Mines-Rocketry-Club/liquid-halfCat/PurchaseItems.xlsx

Sheet: Total
Number | Item | Category | Part Number | Source | Unit Price | QTY | Cost | Context | Notes
F-6 | High-Pressure Braided Chemical Hose with Fittings Brass 1/2"-20 Thread Size Flare UNF Female, 3/8" OD - 42" | Tubing | 4468K812-4468K858 | https://www.mcmaster.com/4468K812-4468K858/ | $31.43 | 1 | $31.43 | Fuel Line 42" Section
F-7 | High-Pressure Braided Chemical Hose with Fittings Brass 1/2"-20 Thread Size Flare UNF Female, 3/8" OD - 14" | Tubing | 4468K812-4468K031 | https://www.mcmaster.com/4468K812-4468K031/ | $19.32 | 1 | $19.32 | Fuel Line 14" Section
F-8 | High-Pressure Braided Chemical Hose with Fittings Brass 9/16"-18 Thread Size Flare UNF Female, 7/16" OD - 12" | Tubing | 4468K813-4468K865 | https://www.mcmaster.com/4468K813-4468K865/ | $26.22 | 1 | $26.22 | Oxidizer Line
F-11 | Nylon Tubing, 1/4" OD, 800PSI, 10ft | Tubing | 9685T3 | https://www.mcmaster.com/9685t3/ | $11.50 | 1 | $11.50 | Fill tube | Select 10 ft length for order
P-1 | 6061 Aluminum Round 4"D X 1/2"L | Stock | 1610T37-1610T134 | https://www.mcmaster.com/1610T37-1610T134/ | $14.21 | 2 | $28.42 | Tank Bulkheads - To be machined into BKHD-FL-O238-4NPT2X250C and BKHD-OX-O238-8NPT4NPT
P-2 | 6061 Aluminum Round 4"D X 3"L | Stock | 1610737-1610T33 | https://www.mcmaster.com/1610T37-1610T33/ | $44.40 | 1 | $44.40 | Tank Piston - To be machined into PSTN-2XO238-250T20
P-3 | 6061 Aluminum Tube 4"D X 1/8"W X 36"L | Stock | 9056K42-9056K423 | https://www.mcmaster.com/9056K42-9056K423 | $82.72 | 1 | $82.72 | Tank Casing - To be machined into TANK-36L-047V2X8X313C
P-4 | 6061 Aluminum Tube 4"OD X 1/2"W X 3"L | Stock | 7392T263 | https://www.mcmaster.com/7392T263/ | $15.71 | 2 | $31.42 | Bolted Tank Rings - To be machined into INRG-200S-8X125C8X250C
F-15 | 3/4" X 6" 6061-T6 Round Bar | Stock | 8974K11-8974K299 | https://www.mcmaster.com/8974K11-8974K299/ | $3.68 | 1 | $3.68 | QD Stock - To be machined into QDC-750X125FLG-281FB8NPT and QDC-750x125FLG-270MB-O007
T-1 | 6061 Aluminum Round 3"D X 6"L | Stock | 8974K82-1610T41 | https://www.mcmaster.com/8974K82-1610T41/ | $47.24 | 1 | $47.24 | Nozzle and injector stock - To be machined into INJC-2X8NPT-38NPT-250T20-2XO230-BASIC and NZZL-45C20D-200E
T-2 | 6061 Aluminum Tube 3"D X 1/2"W X 6"L | Stock | 9056K23-9056K235 | https://www.mcmaster.com/9056K23-9056K235/ | $39.29 | 1 | $39.29 | Chamber Tube - To be machined into CMBR-200DI-250B-525L
T-3 | 110 Copper Round Bar 1-1/2" Diameter 2" Long | Stock | 9103K9-9103K93 | https://www.mcmaster.com/9103K9-9103K93/ | $52.31 | 1 | $52.31 | Nozzle Throat Insert - To be machined into THRT-45C20D-100T
T-18 | 1/4" Carbon Steel Plate 4.5"x12" (2x 4"OD) | Stock | 8910K587-8910K588 | https://www.mcmaster.com/8910K587-8910K588/ | $34.86 | 1 | $34.86 | To be cut/machined into 2x FLNG-ST-25T-8X250C
T-19 | 1/8" 5052 H32 Aluminum Plate 2"x24" (8x 2.5x1) | Stock | 88895K86 | https://www.mcmaster.com/88895k86/ | $17.20 | 1 | $17.20 | To be cut/machined into 8x BRKT-90A-125T-2X250C
T-20 | 3/16" 5052 H32 Aluminum Plate 4"x24" (3x 4" OD) | Stock | 9135K26-9135K262 | https://www.mcmaster.com/9135K26-9135K262/ | $38.72 | 1 | $38.72 | To be cut/machined into 3x BKHD-REC-4X250C-2X170WE
P-5 | -238 Buna-N O-Rings (Pack of 50) | O-Rings | 9452K226 | https://www.mcmaster.com/9452K226/ | $17.60 | 1 | $17.60 | Tank-Piston Seal
F-16 | -007 Buna-N O-rings (Pack of 100) | O-Rings | 9452K15 | https://www.mcmaster.com/9452K15/ | $2.58 | 1 | $2.58 | QD Seal
T-6 | -141 Silicone O-rings (Pack of 10) | O-rings | 9396K79 | https://www.mcmaster.com/9396K79/ | $10.17 | 1 | $10.17 | Injector Seals
P-13 | Nut Retaining Ring | Misc | NTRG-45C20D-200E |  | N/A | 2 | N/A | 3D Printed
P-14 | Propellant Tank Drill Jig | Misc | DRLJG-TANK-8X625OD-BSHNG |  | N/A | 1 | N/A | 3D Printed
F-18 | Quick Disconect Clip, for 3/4" x 1/8" Flange | Misc | QDC-750X250CLP |  | N/A | 1 | N/A | 3D Printed
V-13 | Servo Valve Mount | Misc | SABV-HCON-V2 |  | N/A | 1 | N/A | Valve Actuator Housing
V-14 | Servo Valve Handle Connector | Misc | SABV-MOUNT-V2 |  | N/A | 1 | N/A | Valve Actuator Housing
P-6 | 5/16-24 X 12" Button Head Screw (Pack of 25) | Hardware | 91255A378 | https://www.mcmaster.com/91255A378/ | $7.88 | 1 | $7.88 | Tank Bolts
P-7 | 5/16-24 Offset Narrow Base Weld Nut (Pack of 25) | Hardware | 94579A550 | https://www.mcmaster.com/94579A550/ | $9.21 | 1 | $9.21 | Tank Bolt Nuts
P-8 | 1/4-20 X 7/8 Button Head Hex Drive Screws (Pack of 50) | Hardware | 91306A279 | https://www.mcmaster.com/91306a279/ | $9.30 | 1 | $9.30 | Forward Bulkhead Recovery Anchors and Fin Brackets/Airframe
P-9 | 1/4-20 Coupling Nut | Hardware | 90264A435 | https://www.mcmaster.com/90264A435/ | $0.39 | 2 | $0.78 | Forward Bulkhead Recovery Anchors
P-10 | Sealing Washers for 1/4" Screw, 0.5" OD (Pack of 10) | Hardware | 91367A952 | https://www.mcmaster.com/91367A952/ | $7.49 | 1 | $7.49 | Forward Bulkhead Recovery Anchors
P-11 | Ultra-Low-Profile Socket Head Screw Alloy Steel, 1/4"-20 Thread Size, 1/2" Long | Hardware | 90357A013 | https://www.mcmaster.com/90357A013/ | $5.23 | 2 | $10.46 | Propellant Piston Extraction | Not worth $5 per screw, find alternate (machine custom or alt. product)
P-12 | Spacer for 5/16", 5/8" OD x 12" Long | Hardware | 93320A215 | https://www.mcmaster.com/93320A215/ | $4.31 | 1 | $4.31 | Bushing for Tank Drill Jig
V-3 | 8-32 Hex Nut, Low Strength (Pack of 100) | Hardware | 90480A009 | https://www.mcmaster.com/90480A009/ | $2.02 | 1 | $2.02 | Valve Handle Screw
V-4 | M4 X 0.7 Hex Nut, Low Strength (Pack of 100) | Hardware | 90591A141 | https://www.mcmaster.com/90591A141/ | $1.90 | 1 | $1.90 | Servo Mount Screws | Should change this to keep everything imperial
V-5 | 8-32 X 1/2"L Screw, Zinc Plated Steel (Pack of 100) | Hardware | 90272A194 | https://www.mcmaster.com/90272A194/ | $3.98 | 1 | $3.98 | Valve Handle Screw
V-6 | M4 X 0.7 X 16mm Hex Head Screws, 18-8SS (Pack of 100) | Hardware | 91280A044 | https://www.mcmaster.com/91280a044/ | $10.56 | 1 | $10.56 | Servo Mount/Avbay Sled Screws | Should change this to keep everything imperial
V-7 | M4 Washer, 8mm OD, 18-8SS (Pack of 100) | Hardware | 98689A113 | https://www.mcmaster.com/98689A113/ | $3.43 | 1 | $3.43 | Servo Mount Screws | Should change this to keep everything imperial
V-8 | M4 Split Lock Washer, 18-8SS (Pack of 100) | Hardware | 92148A160 | https://www.mcmaster.com/92148A160/ | $1.94 | 1 | $1.94 | Servo Mount Screws | Should change this to keep everything imperial
V-9 | M3 Flat Washer, 18-8SS, 7mm OD (Pack of 100) | Hardware | 93475A210 | https://www.mcmaster.com/93475A210/ | $2.19 | 1 | $2.19 | Servo Horn Connector | Should change this to keep everything imperial
V-10 | M3 X 0.5 10mm Low Profile Socket Head Screw, 18-8SS (Pack of 25) | Hardware | 92855A310 | https://www.mcmaster.com/92855A310/ | $2.28 | 1 | $2.28 | Servo Horn Connector | Should change this to keep everything imperial
T-7 | Inverted External Retaining Ring for 2.5" OD | Hardware | 90213A101 | https://www.mcmaster.com/90213a101/ | $1.27 | 1 | $1.27 | Injector Flange
T-8 | Graphite Pipe Gasket, Size 1 | Hardware | 94095K114 | https://www.mcmaster.com/94095K114/ | $3.11 | 2 | $6.22 | Chamber/nozzle seal
T-9 | Flange Plate, Thrust Chamber, Steel, 1/4" | Hardware | FLNG-ST-25T-8X250C |  |  | 2 | $0.00 | Chamber flanges | No stock listed for these parts
T-10 | Bracket, Thrust Chamber Mounting, Aluminum, 1/8" | Hardware | BRKT-90A-125T-2X250C |  |  | 8 | $0.00 | Chamber attachment to fin brackets | No stock listed for these parts
T-11 | 1/4 Washers 5/8" OD 18-8SS (Pack of 100) | Hardware | 92141A029 | https://www.mcmaster.com/92141A029/ | $5.50 | 2 | $11.00 | Chamber tie rods, fins, avbay
T-12 | Split Lock Washer for 1/4 Screw Size (Pack of 100) | Hardware | 91102A750 | https://www.mcmaster.com/91102A750/ | $3.02 | 1 | $3.02 | Chamber tie rods, fins, avbay
T-13 | 1/4-20 Medium Strength Hex Nuts (Pack of 100) | Hardware | 95505A601 | https://www.mcmaster.com/95505A601/ | $7.08 | 1 | $7.08 | Chamber tie rods, fins, avbay
T-14 | 1/4-20 X 8"L Black Oxide Threaded on Both Ends Stud | Hardware | 90281A102 | https://www.mcmaster.com/90281A102/ | $2.46 | 8 | $19.68 | Chamber tie rods | Additional on Airframe
T-15 | Low-Profile Ultra-Wd Truss Head Slotted Screw 1/4"-20 Thread, 3/4" Long (Pack of 10) | Hardware | 90015A410 | https://www.mcmaster.com/90015A410/ | $7.93 | 1 | $7.93 | Scrintle Screw
T-16 | High-Temperature Dry-Running 841 Bronze Sleeve Bearing for 1/4" Shaft Diameter and 3/8" Housing ID, 3/8" Long | Hardware | 9368T14 | https://www.mcmaster.com/9368T14/ | $1.07 | 1 | $1.07 | Scrintle Sleeve
T-17 | Garter Spring Hard Drawn Steel, 1.529" OD, 1.341" ID | Hardware | 8284N57 | https://www.mcmaster.com/8284N57/ | $6.32 | 1 | $6.32 | Nozzle Insert Retainer
F-1 | Aluminum Pipe Nipple, 1/4NPT, 4"L | Fittings | 44665K137 | https://www.mcmaster.com/44665K137/ | $6.97 | 2 | $13.94 | Tank outlets to valves
F-2 | Nbrass High Pressure Elbow Fitting, M/F, 1/4NPT | Fittings | 50785K43 | https://www.mcmaster.com/50785K43/ | $3.25 | 2 | $6.50 | Fuel valve outlet
F-3 | High-Pressure Brass Straight Reducer, 1/4 x 1/8NPT Male | Fittings | 5485K31 | https://www.mcmaster.com/5485K31/ | $2.64 | 1 | $2.64 | Fuel valve outlet
F-4 | High-Pressure Brass Elbow Connector, 1/8NPT Female | Fittings | 50785K35 | https://www.mcmaster.com/50785K35/ | $3.31 | 1 | $3.31 | Fuel valve outlet
F-5 | 37 Degree Flared Adapter for 5/16" Tube OD, 1/8 Pipe Size | Fittings | 50675K435 | https://www.mcmaster.com/50675K435/ | $5.38 | 1 | $5.38 | Fuel valve outlet
F-9 | 37 Degree Flared Straight Connector for 5/16" Tube OD, 1-3/8" Long | Fittings | 50675K135 | https://www.mcmaster.com/50675K135/ | $4.47 | 1 | $4.47 | Fuel Line Union
F-10 | 37 Degree Flared Adapter for 3/8" Tube OD x 1/4 NPT Male | Fittings | 50675K163 | https://www.mcmaster.com/50675k163/ | $3.65 | 1 | $3.65 | Ox Valve Outlet
F-12 | Check Valve, 1/8NPT Female/Male, Brass | Fittings | 7768K21 | https://www.mcmaster.com/7768K21/ | $19.26 | 1 | $19.26 | Fill
F-13 | Elbow, 1/8NPT, Male/Female, Brass | Fittings | 50785K41 | https://www.mcmaster.com/50785k41/ | $2.16 | 1 | $2.16 | Fill check to QD
F-14 | Push to Connect Fitting, 1/4" Tube X 1/8NPT | Fittings | 9396T31 | https://www.mcmaster.com/9396T31/ | $3.95 | 2 | $7.90 | Fill check to QD
F-17 | High Pressure Brass Straight adapter, 1/4NPT Female x Male | Fittings | 50785K27 | https://www.mcmaster.com/50785K27/ | $2.66 | 1 | $2.66 | Fuel valve outlet spacer
V-2 | Compact High Pressure Ball Valve, 1/4NPT | Fittings | 4112T22 | https://www.mcmaster.com/4112T22 | $17.26 | 2 | $34.52 | Fuel/Ox Valves
T-4 | 37 Degree Flared Adapter for 5/16" Tube OD, 1/8 Pipe Size | Fittings | 50675K435 | https://www.mcmaster.com/50675K435 | $5.38 | 1 | $5.38 | Fuel Inlet
T-5 | 37 Degree Flared Adapter for 3/8" Tube OD x 3/8 NPT Male | Fittings | 50675K164 | https://www.mcmaster.com/50675K164/ | $5.18 | 1 | $5.18 | Ox Inlet
I-1 | Thick-Wall Pipe Nipple, 1/2NPT X 2"L, Aluminum | Fittings | 2155K18 | https://www.mcmaster.com/2155k18/ | $11.27 | 1 | $11.27 | Cartridge Body
I-2 | 1/2NPT Cap, Brass | Fittings | 50785K164 | https://www.mcmaster.com/50785K164/ | $2.96 | 1 | $2.96 | Cartridge Cap
I-3 | 1/2NPT Coupling, Brass | Fittings | 50785K94 | https://www.mcmaster.com/50785K94/ | $4.05 | 1 | $4.05 | Cartridge Body
I-4 | NPT Bushing, 1/2 Male X 1/8 Female, Brass | Fittings | 4429K421 | https://www.mcmaster.com/4429K421/ | $4.72 | 1 | $4.72 | Cartridge Bottom
I-5 | Pipe Nipple, 1/8NPT X 2"L, Brass | Fittings | 50785K171 | https://www.mcmaster.com/50785K171/ | $3.32 | 1 | $3.32 | Cartridge Outlet
I-6 | High-Pressure Brass Pipe Fitting Straight Adapter with Hex Body, 1/8NPT Female x Male | Fittings | 50785K25 | https://www.mcmaster.com/50785K25/ | $1.40 | 1 | $1.40 | Cartridge Outlet
I-7 | High-Pressure Brass Pipe Straight Connector, 1/8NPT Male | Fittings | 5485K21 | https://www.mcmaster.com/5485K21/ | $1.66 | 1 | $1.66 | Cartridge Outlet
I-8 | High-Pressure Brass Straight Connector with Hex Body, 1/8NPT Female | Fittings | 50785K91 | https://www.mcmaster.com/50785K91/ | $1.46 | 1 | $1.46 | Igniter Inlet
V-1 | 25kg Servo w/ 25T Servo Horn (Pack of 2) | Electronics | DS3225 | https://www.amazon.com/Miuzei-Waterproof-Compatible-Steering-Horn%EF%BC%88270%C2%B0%EF%BC%89/dp/B0C5LTKBD4 | $28.88 | 1 | $28.88 | Fuel/Ox valve actuators
V-11 | 3-pin Servo Extension Cables, 1m (Pack of 10) | Electronics | SRV-3PIN-1MXT | https://www.amazon.com/Extension-Female-Connectors-Control-11-8In-15Pcs/dp/B0CG3CDQ94 | $11.99 | 1 | $11.99 | Servo Wires
V-12 | 3-Pin Servo Y-Harness | Electronics | SRV-Y-HRNS | https://www.amazon.com/Splitter-Connector-Extension-Compatible-Airplanes/dp/B09VNQPP91 | $8.99 | 1 | $8.99
TOTAL |  |  |  |  |  |  | $878.05

Sheet: Propellant Tank
Number | Item | Category | Part Number | Source | Unit Price | QTY | Cost | Context | Notes
P-1 | 6061 Aluminum Round 4"D X 1/2"L | Stock | 1610T37-1610T134 | https://www.mcmaster.com/1610T37-1610T134/ | $14.21 | 2 | $28.42 | Tank Bulkheads - To be machined into BKHD-FL-O238-4NPT2X250C and BKHD-OX-O238-8NPT4NPT
P-2 | 6061 Aluminum Round 4"D X 3"L | Stock | 1610737-1610T33 | https://www.mcmaster.com/1610T37-1610T33/ | $44.40 | 1 | $44.40 | Tank Piston - To be machined into PSTN-2XO238-250T20
P-3 | 6061 Aluminum Tube 4"D X 1/8"W X 36"L | Stock | 9056K42-9056K423 | https://www.mcmaster.com/9056K42-9056K423 | $82.72 | 1 | $82.72 | Tank Casing - To be machined into TANK-36L-047V2X8X313C | COPV?
P-4 | 6061 Aluminum Tube 4"OD X 1/2"W X 3"L | Stock | 7392T263 | https://www.mcmaster.com/7392T263/ | $15.71 | 2 | $31.42 | Bolted Tank Rings - To be machined into INRG-200S-8X125C8X250C
P-5 | -238 Buna-N O-Rings (Pack of 50) | O-Rings | 9452K226 | https://www.mcmaster.com/9452K226/ | $17.60 | 1 | $17.60 | Tank-Piston Seal
P-6 | 5/16-24 X 12" Button Head Screw (Pack of 25) | Hardware | 91255A378 | https://www.mcmaster.com/91255A378/ | $7.88 | 1 | $7.88 | Tank Bolts
P-7 | 5/16-24 Offset Narrow Base Weld Nut (Pack of 25) | Hardware | 94579A550 | https://www.mcmaster.com/94579A550/ | $9.21 | 1 | $9.21 | Tank Bolt Nuts
P-8 | 1/4-20 X 7/8 Button Head Hex Drive Screws (Pack of 50) | Hardware | 91306A279 | https://www.mcmaster.com/91306a279/ | $9.30 | 1 | $9.30 | Forward Bulkhead Recovery Anchors and Fin Brackets/Airframe
P-9 | 1/4-20 Coupling Nut | Hardware | 90264A435 | https://www.mcmaster.com/90264A435/ | $0.39 | 2 | $0.78 | Forward Bulkhead Recovery Anchors
P-10 | Sealing Washers for 1/4" Screw, 0.5" OD (Pack of 10) | Hardware | 91367A952 | https://www.mcmaster.com/91367A952/ | $7.49 | 1 | $7.49 | Forward Bulkhead Recovery Anchors
P-11 | Ultra-Low-Profile Socket Head Screw Alloy Steel, 1/4"-20 Thread Size, 1/2" Long | Hardware | 90357A013 | https://www.mcmaster.com/90357A013/ | $5.23 | 2 | $10.46 | Propellant Piston Extraction | Not worth $5 per screw, find alternate (machine custom or alt. product)
P-12 | Spacer for 5/16", 5/8" OD x 12" Long | Hardware | 93320A215 | https://www.mcmaster.com/93320A215/ | $4.31 | 1 | $4.31 | Bushing for Tank Drill Jig
P-13 | Nut Retaining Ring | Misc | NTRG-45C20D-200E |  | N/A | 2 | N/A | 3D Printed
P-14 | Propellant Tank Drill Jig | Misc | DRLJG-TANK-8X625OD-BSHNG |  | N/A | 1 | N/A | 3D Printed
 | TOTAL |  |  |  |  |  | $253.99

Sheet: Fluid System
Number | Item | Category | Part Number | Source | Unit Price | QTY | Cost | Context | Notes
F-1 | Aluminum Pipe Nipple, 1/4NPT, 4"L | Fittings | 44665K137 | https://www.mcmaster.com/44665K137/ | $6.97 | 2 | $13.94 | Tank outlets to valves
F-2 | Nbrass High Pressure Elbow Fitting, M/F, 1/4NPT | Fittings | 50785K43 | https://www.mcmaster.com/50785K43/ | $3.25 | 2 | $6.50 | Fuel valve outlet
F-3 | High-Pressure Brass Straight Reducer, 1/4 x 1/8NPT Male | Fittings | 5485K31 | https://www.mcmaster.com/5485K31/ | $2.64 | 1 | $2.64 | Fuel valve outlet
F-4 | High-Pressure Brass Elbow Connector, 1/8NPT Female | Fittings | 50785K35 | https://www.mcmaster.com/50785K35/ | $3.31 | 1 | $3.31 | Fuel valve outlet
F-5 | 37 Degree Flared Adapter for 5/16" Tube OD, 1/8 Pipe Size | Fittings | 50675K435 | https://www.mcmaster.com/50675K435/ | $5.38 | 1 | $5.38 | Fuel valve outlet
F-6 | High-Pressure Braided Chemical Hose with Fittings Brass 1/2"-20 Thread Size Flare UNF Female, 3/8" OD - 42" | Tubing | 4468K812-4468K858 | https://www.mcmaster.com/4468K812-4468K858/ | $31.43 | 1 | $31.43 | Fuel Line 42" Section
F-7 | High-Pressure Braided Chemical Hose with Fittings Brass 1/2"-20 Thread Size Flare UNF Female, 3/8" OD - 14" | Tubing | 4468K812-4468K031 | https://www.mcmaster.com/4468K812-4468K031/ | $19.32 | 1 | $19.32 | Fuel Line 14" Section
F-8 | High-Pressure Braided Chemical Hose with Fittings Brass 9/16"-18 Thread Size Flare UNF Female, 7/16" OD - 12" | Tubing | 4468K813-4468K865 | https://www.mcmaster.com/4468K813-4468K865/ | $26.22 | 1 | $26.22 | Oxidizer Line
F-9 | 37 Degree Flared Straight Connector for 5/16" Tube OD, 1-3/8" Long | Fittings | 50675K135 | https://www.mcmaster.com/50675K135/ | $4.47 | 1 | $4.47 | Fuel Line Union
F-10 | 37 Degree Flared Adapter for 3/8" Tube OD x 1/4 NPT Male | Fittings | 50675K163 | https://www.mcmaster.com/50675k163/ | $3.65 | 1 | $3.65 | Ox Valve Outlet
F-11 | Nylon Tubing, 1/4" OD, 800PSI, 10ft | Tubing | 9685T3 | https://www.mcmaster.com/9685t3/ | $11.50 | 1 | $11.50 | Fill tube | Select 10 ft length for order
F-12 | Check Valve, 1/8NPT Female/Male, Brass | Fittings | 7768K21 | https://www.mcmaster.com/7768K21/ | $19.26 | 1 | $19.26 | Fill
F-13 | Elbow, 1/8NPT, Male/Female, Brass | Fittings | 50785K41 | https://www.mcmaster.com/50785k41/ | $2.16 | 1 | $2.16 | Fill check to QD
F-14 | Push to Connect Fitting, 1/4" Tube X 1/8NPT | Fittings | 9396T31 | https://www.mcmaster.com/9396T31/ | $3.95 | 2 | $7.90 | Fill check to QD
F-15 | 3/4" X 6" 6061-T6 Round Bar | Stock | 8974K11-8974K299 | https://www.mcmaster.com/8974K11-8974K299/ | $3.68 | 1 | $3.68 | QD Stock - To be machined into QDC-750X125FLG-281FB8NPT and QDC-750x125FLG-270MB-O007
F-16 | -007 Buna-N O-rings (Pack of 100) | O-Rings | 9452K15 | https://www.mcmaster.com/9452K15/ | $2.58 | 1 | $2.58 | QD Seal
F-17 | High Pressure Brass Straight adapter, 1/4NPT Female x Male | Fittings | 50785K27 | https://www.mcmaster.com/50785K27/ | $2.66 | 1 | $2.66 | Fuel valve outlet spacer
F-18 | Quick Disconect Clip, for 3/4" x 1/8" Flange | Misc | QDC-750X250CLP |  | N/A | 1 | N/A | 3D Printed
 | TOTAL |  |  |  |  |  | $166.60

Sheet: Valves
Number | Item | Category | Part Number | Source | Unit Price | QTY | Cost | Context | Notes
V-1 | 25kg Servo w/ 25T Servo Horn (Pack of 2) | Electronics | DS3225 | https://www.amazon.com/Miuzei-Waterproof-Compatible-Steering-Horn%EF%BC%88270%C2%B0%EF%BC%89/dp/B0C5LTKBD4 | $28.88 | 1 | $28.88 | Fuel/Ox valve actuators
V-2 | Compact High Pressure Ball Valve, 1/4NPT | Fittings | 4112T22 | https://www.mcmaster.com/4112T22 | $17.26 | 2 | $34.52 | Fuel/Ox Valves
V-3 | 8-32 Hex Nut, Low Strength (Pack of 100) | Hardware | 90480A009 | https://www.mcmaster.com/90480A009/ | $2.02 | 1 | $2.02 | Valve Handle Screw
V-4 | M4 X 0.7 Hex Nut, Low Strength (Pack of 100) | Hardware | 90591A141 | https://www.mcmaster.com/90591A141/ | $1.90 | 1 | $1.90 | Servo Mount Screws | Should change this to keep everything imperial
V-5 | 8-32 X 1/2"L Screw, Zinc Plated Steel (Pack of 100) | Hardware | 90272A194 | https://www.mcmaster.com/90272A194/ | $3.98 | 1 | $3.98 | Valve Handle Screw
V-6 | M4 X 0.7 X 16mm Hex Head Screws, 18-8SS (Pack of 100) | Hardware | 91280A044 | https://www.mcmaster.com/91280a044/ | $10.56 | 1 | $10.56 | Servo Mount/Avbay Sled Screws | Should change this to keep everything imperial
V-7 | M4 Washer, 8mm OD, 18-8SS (Pack of 100) | Hardware | 98689A113 | https://www.mcmaster.com/98689A113/ | $3.43 | 1 | $3.43 | Servo Mount Screws | Should change this to keep everything imperial
V-8 | M4 Split Lock Washer, 18-8SS (Pack of 100) | Hardware | 92148A160 | https://www.mcmaster.com/92148A160/ | $1.94 | 1 | $1.94 | Servo Mount Screws | Should change this to keep everything imperial
V-9 | M3 Flat Washer, 18-8SS, 7mm OD (Pack of 100) | Hardware | 93475A210 | https://www.mcmaster.com/93475A210/ | $2.19 | 1 | $2.19 | Servo Horn Connector | Should change this to keep everything imperial
V-10 | M3 X 0.5 10mm Low Profile Socket Head Screw, 18-8SS (Pack of 25) | Hardware | 92855A310 | https://www.mcmaster.com/92855A310/ | $2.28 | 1 | $2.28 | Servo Horn Connector | Should change this to keep everything imperial
V-11 | 3-pin Servo Extension Cables, 1m (Pack of 10) | Electronics | SRV-3PIN-1MXT | https://www.amazon.com/Extension-Female-Connectors-Control-11-8In-15Pcs/dp/B0CG3CDQ94 | $11.99 | 1 | $11.99 | Servo Wires
V-12 | 3-Pin Servo Y-Harness | Electronics | SRV-Y-HRNS | https://www.amazon.com/Splitter-Connector-Extension-Compatible-Airplanes/dp/B09VNQPP91 | $8.99 | 1 | $8.99
V-13 | Servo Valve Mount | Misc | SABV-HCON-V2 |  | N/A | 1 | N/A | Valve Actuator Housing
V-14 | Servo Valve Handle Connector | Misc | SABV-MOUNT-V2 |  | N/A | 1 | N/A | Valve Actuator Housing
TOTAL |  |  |  |  |  |  | $112.68

Sheet: Thrust Chamber
Number | Item | Category | Part Number | Source | Unit Price | QTY | Cost | Context | Notes
T-1 | 6061 Aluminum Round 3"D X 6"L | Stock | 8974K82-1610T41 | https://www.mcmaster.com/8974K82-1610T41/ | $47.24 | 1 | $47.24 | Nozzle and injector stock - To be machined into INJC-2X8NPT-38NPT-250T20-2XO230-BASIC and NZZL-45C20D-200E
T-2 | 6061 Aluminum Tube 3"D X 1/2"W X 6"L | Stock | 9056K23-9056K235 | https://www.mcmaster.com/9056K23-9056K235/ | $39.29 | 1 | $39.29 | Chamber Tube - To be machined into CMBR-200DI-250B-525L
T-3 | 110 Copper Round Bar 1-1/2" Diameter 2" Long | Stock | 9103K9-9103K93 | https://www.mcmaster.com/9103K9-9103K93/ | $52.31 | 1 | $52.31 | Nozzle Throat Insert - To be machined into THRT-45C20D-100T
T-4 | 37 Degree Flared Adapter for 5/16" Tube OD, 1/8 Pipe Size | Fittings | 50675K435 | https://www.mcmaster.com/50675K435 | $5.38 | 1 | $5.38 | Fuel Inlet
T-5 | 37 Degree Flared Adapter for 3/8" Tube OD x 3/8 NPT Male | Fittings | 50675K164 | https://www.mcmaster.com/50675K164/ | $5.18 | 1 | $5.18 | Ox Inlet
T-6 | -141 Silicone O-rings (Pack of 10) | O-rings | 9396K79 | https://www.mcmaster.com/9396K79/ | $10.17 | 1 | $10.17 | Injector Seals
T-7 | Inverted External Retaining Ring for 2.5" OD | Hardware | 90213A101 | https://www.mcmaster.com/90213a101/ | $1.27 | 1 | $1.27 | Injector Flange
T-8 | Graphite Pipe Gasket, Size 1 | Hardware | 94095K114 | https://www.mcmaster.com/94095K114/ | $3.11 | 2 | $6.22 | Chamber/nozzle seal
T-9 | Flange Plate, Thrust Chamber, Steel, 1/4" | Hardware | FLNG-ST-25T-8X250C |  |  | 2 | $0.00 | Chamber flanges | No stock listed for these parts
T-10 | Bracket, Thrust Chamber Mounting, Aluminum, 1/8" | Hardware | BRKT-90A-125T-2X250C |  |  | 8 | $0.00 | Chamber attachment to fin brackets | No stock listed for these parts
T-11 | 1/4 Washers 5/8" OD 18-8SS (Pack of 100) | Hardware | 92141A029 | https://www.mcmaster.com/92141A029/ | $5.50 | 2 | $11.00 | Chamber tie rods, fins, avbay
T-12 | Split Lock Washer for 1/4 Screw Size (Pack of 100) | Hardware | 91102A750 | https://www.mcmaster.com/91102A750/ | $3.02 | 1 | $3.02 | Chamber tie rods, fins, avbay
T-13 | 1/4-20 Medium Strength Hex Nuts (Pack of 100) | Hardware | 95505A601 | https://www.mcmaster.com/95505A601/ | $7.08 | 1 | $7.08 | Chamber tie rods, fins, avbay
T-14 | 1/4-20 X 8"L Black Oxide Threaded on Both Ends Stud | Hardware | 90281A102 | https://www.mcmaster.com/90281A102/ | $2.46 | 8 | $19.68 | Chamber tie rods | Additional on Airframe
T-15 | Low-Profile Ultra-Wd Truss Head Slotted Screw 1/4"-20 Thread, 3/4" Long (Pack of 10) | Hardware | 90015A410 | https://www.mcmaster.com/90015A410/ | $7.93 | 1 | $7.93 | Scrintle Screw
T-16 | High-Temperature Dry-Running 841 Bronze Sleeve Bearing for 1/4" Shaft Diameter and 3/8" Housing ID, 3/8" Long | Hardware | 9368T14 | https://www.mcmaster.com/9368T14/ | $1.07 | 1 | $1.07 | Scrintle Sleeve
T-17 | Garter Spring Hard Drawn Steel, 1.529" OD, 1.341" ID | Hardware | 8284N57 | https://www.mcmaster.com/8284N57/ | $6.32 | 1 | $6.32 | Nozzle Insert Retainer
T-18 | 1/4" Carbon Steel Plate 4.5"x12" (2x 4"OD) | Stock | 8910K587-8910K588 | https://www.mcmaster.com/8910K587-8910K588/ | $34.86 | 1 | $34.86 | To be cut/machined into FLNG-ST-25T-8X250C
T-19 | 1/8" 5052 H32 Aluminum Plate 2"x24" (8x 2.5x1) | Stock | 88895K86 | https://www.mcmaster.com/88895k86/ | $17.20 | 1 | $17.20 | To be cut/machined into BRKT-90A-125T-2X250C
T-20 | 3/16" 5052 H32 Aluminum Plate 4"x24" (3x 4" OD) | Stock | 9135K26-9135K262 | https://www.mcmaster.com/9135K26-9135K262/ | $38.72 | 1 | $38.72 | To be cut/machined into BKHD-REC-4X250C-2X170WE
 | TOTAL |  |  |  |  |  | $313.94

Sheet: Igniter
Number | Item | Category | Part Number | Source | Unit Price | QTY | Cost | Context | Notes
I-1 | Thick-Wall Pipe Nipple, 1/2NPT X 2"L, Aluminum | Fittings | 2155K18 | https://www.mcmaster.com/2155k18/ | $11.27 | 1 | $11.27 | Cartridge Body
I-2 | 1/2NPT Cap, Brass | Fittings | 50785K164 | https://www.mcmaster.com/50785K164/ | $2.96 | 1 | $2.96 | Cartridge Cap
I-3 | 1/2NPT Coupling, Brass | Fittings | 50785K94 | https://www.mcmaster.com/50785K94/ | $4.05 | 1 | $4.05 | Cartridge Body
I-4 | NPT Bushing, 1/2 Male X 1/8 Female, Brass | Fittings | 4429K421 | https://www.mcmaster.com/4429K421/ | $4.72 | 1 | $4.72 | Cartridge Bottom
I-5 | Pipe Nipple, 1/8NPT X 2"L, Brass | Fittings | 50785K171 | https://www.mcmaster.com/50785K171/ | $3.32 | 1 | $3.32 | Cartridge Outlet
I-6 | High-Pressure Brass Pipe Fitting Straight Adapter with Hex Body, 1/8NPT Female x Male | Fittings | 50785K25 | https://www.mcmaster.com/50785K25/ | $1.40 | 1 | $1.40 | Cartridge Outlet
I-7 | High-Pressure Brass Pipe Straight Connector, 1/8NPT Male | Fittings | 5485K21 | https://www.mcmaster.com/5485K21/ | $1.66 | 1 | $1.66 | Cartridge Outlet
I-8 | High-Pressure Brass Straight Connector with Hex Body, 1/8NPT Female | Fittings | 50785K91 | https://www.mcmaster.com/50785K91/ | $1.46 | 1 | $1.46 | Igniter Inlet
 | TOTAL |  |  |  |  |  | $30.84
