Mines-Rocketry-Club/liquid-halfCat/CAD/Airframe/Recovery/REC-CHT-MN-84 Parachute, Main, 84 Inch, Mass Volume, Mojave Sphinx.SLDPRT

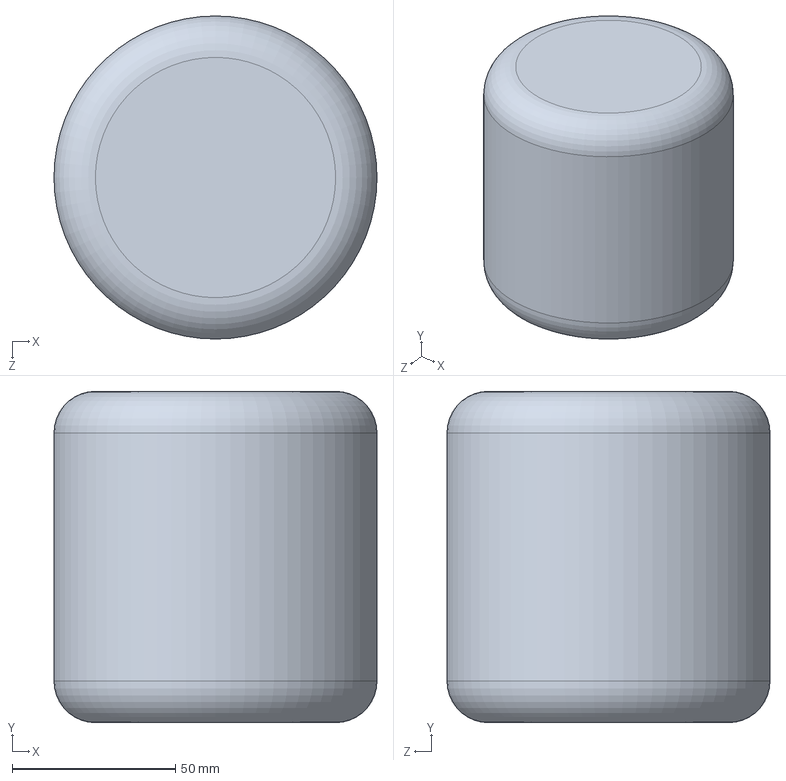
[picture p1: CAD file, 2025-05-20]
CAD/Airframe/Recovery/REC-CHT-MN-84 Parachute, Main, 84 Inch, Mass Volume, Mojave Sphinx.SLDPRT
99.1 x 101.6 x 99.1 mm
