Mines-Rocketry-Club/liquid-halfCat/CAD/Airframe/Recovery/REC-PRT-MN-16, Parachute Protector, Main, 16 Inch, Mass Volume, Mojave Sphinx.SLDPRT

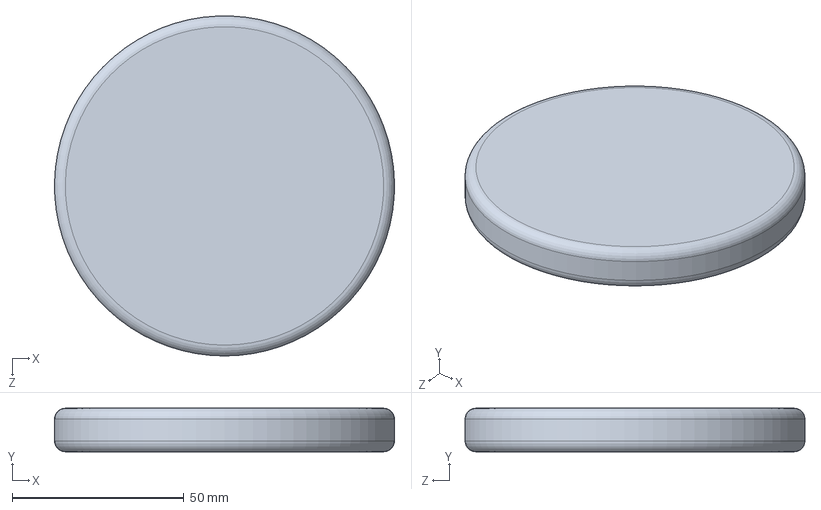
[picture p2: CAD file, 2025-05-20]
CAD/Airframe/Recovery/REC-PRT-MN-16, Parachute Protector, Main, 16 Inch, Mass Volume, Mojave Sphinx.SLDPRT
99.0 x 12.7 x 99.0 mm
