Mines-Rocketry-Club/liquid-halfCat/CAD/Propulsion/Fuel Tank/SABV/SABV-04FF Servo Actuated Ball Valve Assembly, Mojave Sphinx.SLDASM

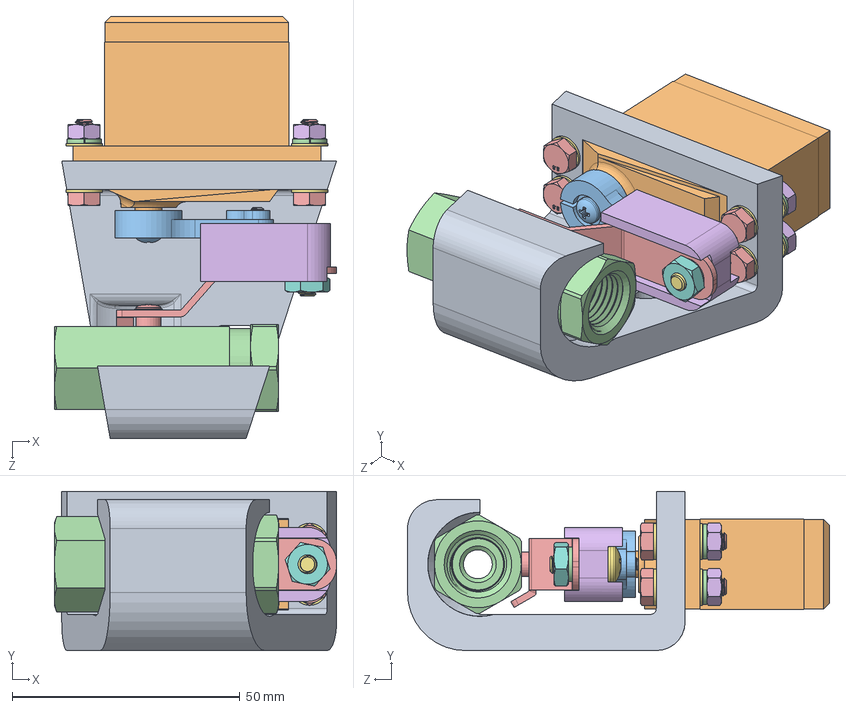
[picture p3: CAD file, 2025-05-20]
CAD/Propulsion/Fuel Tank/SABV/SABV-04FF Servo Actuated Ball Valve Assembly, Mojave Sphinx.SLDASM
61.9 x 34.9 x 92.6 mm
SABV-MNT-04V-3225S Mount, Servo Actuated Ball Valve, Hex Clearance, Mojave Sphinx
DS3225 Servo 25kg-cm
25T Servo Horn
4112T22_Compact High-Pressure Brass Ball Valve - Handle Removed
4112T22_Compact High-Pressure Brass Ball Valve - Handle ONLY
SABV-HCON-04V-3225S Handle Connector, Servo Actuated Ball Valve, Mojave Sphinx
90272A194_ZINC-PLTD STL PAN HEAD PHILLIPS MACHINE SCREW
90480A009_LOW-STRENGTH STEEL HEX NUT
91290A115_BLACK-OXIDE CLASS 12.9 SOCKET HEAD CAP SCREW
98689A112_ METRIC GENERAL PURPOSE WASHERS
92000A076_18-8 SS METRIC PAN HEAD PHIL MACHINE SCREW
92148A160_18-8 Stainless Steel Split Lock Washer x 5
91280A044_MEDIUM-STRENGTH CLASS 8.8 STEEL HEX HEAD SCREW x 4
90591A141_ZINC-PLATED STEEL HEX NUT x 4
98689A113_ METRIC GENERAL PURPOSE WASHERS x 8
