Mines-Rocketry-Club/liquid-halfCat/CAD/Airframe/Avionics/AVBY-HF-3994 Avbay Coupler, Half, Mojave Sphinx.SLDPRT

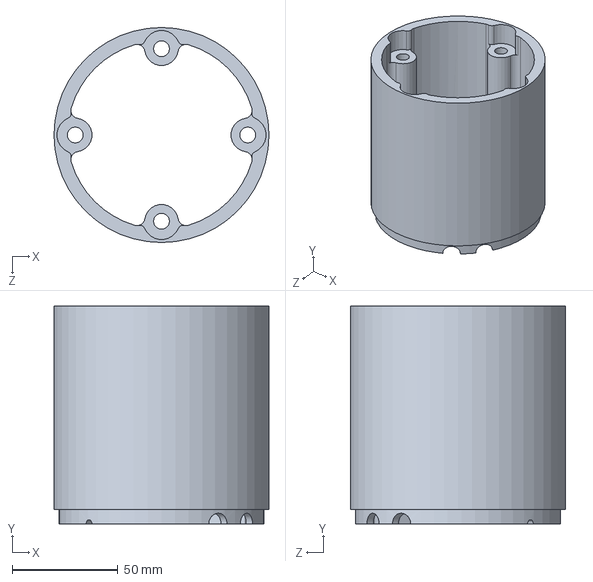
[picture p4: CAD file, 2025-05-20]
CAD/Airframe/Avionics/AVBY-HF-3994 Avbay Coupler, Half, Mojave Sphinx.SLDPRT
101.4 x 102.7 x 101.4 mm
