Mines-Rocketry-Club/liquid-halfCat/CAD/Airframe/Avionics/Avionics Sled/AVBY-SLD-225X600-6XM4C Avbay Sled, Mojave Sphinx.SLDPRT

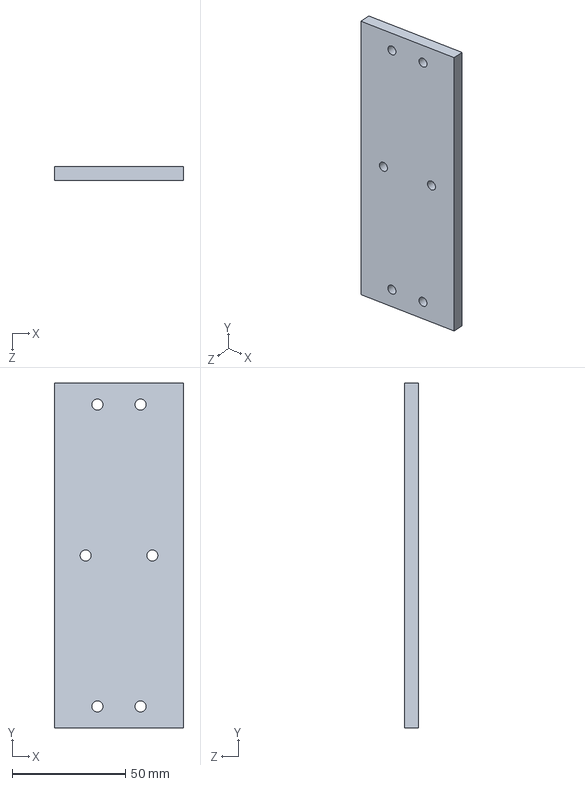
[picture p5: CAD file, 2025-05-20]
CAD/Airframe/Avionics/Avionics Sled/AVBY-SLD-225X600-6XM4C Avbay Sled, Mojave Sphinx.SLDPRT
57.1 x 152.4 x 6.35 mm
