Mines-Rocketry-Club/liquid-halfCat/CAD/Airframe/Nose Cone/NSCN-Shoulder.STEP

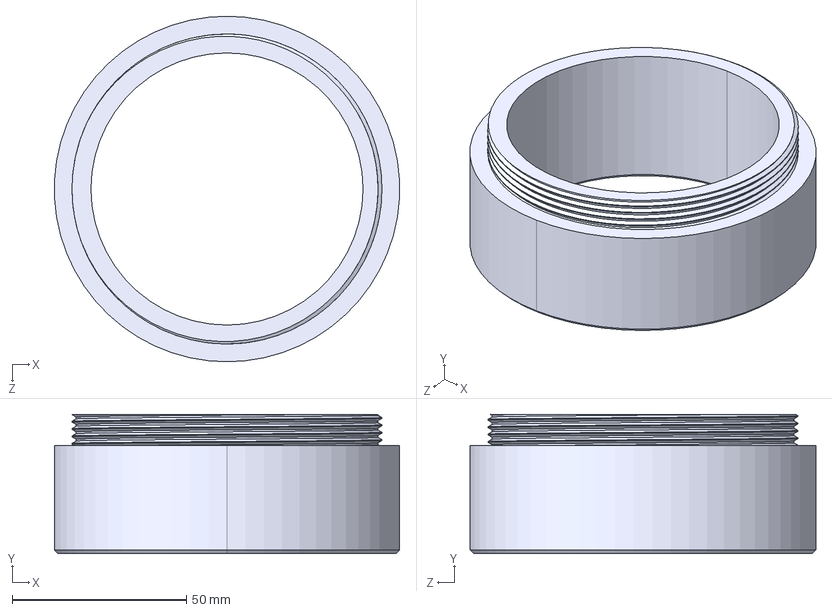
[picture p6: CAD file, 2025-10-15]
CAD/Airframe/Nose Cone/NSCN-Shoulder.STEP
99.1 x 40.0 x 99.2 mm
