Mines-Rocketry-Club/liquid-halfCat/CAD/Propulsion/Fuel Tank/Fuel Bulkhead/BKHD-FL-O238-4NPT-2X250C Tank Bulkhead, Fuel, Mojave Sphinx.SLDPRT

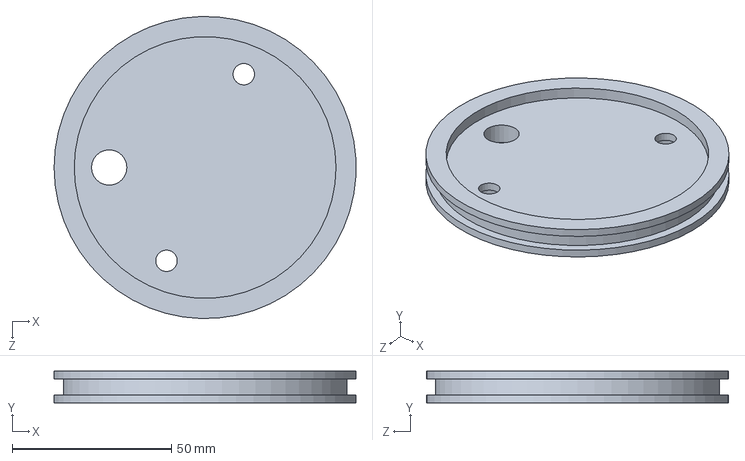
[picture p7: CAD file, 2025-09-22]
CAD/Propulsion/Fuel Tank/Fuel Bulkhead/BKHD-FL-O238-4NPT-2X250C Tank Bulkhead, Fuel, Mojave Sphinx.SLDPRT
94.9 x 9.91 x 95.0 mm
