Mines-Rocketry-Club/liquid-halfCat/CAD/Propulsion/Fuel Tank/Quick Disconnect/QDC-750x125FLG-270MB-O007-8NPT Quick Disconnect, Male, Mojave Sphinx.SLDPRT

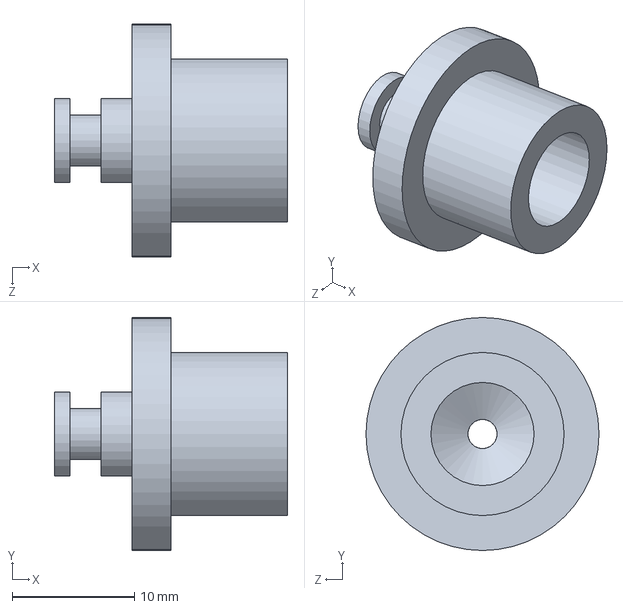
[picture p8: CAD file, 2025-09-22]
CAD/Propulsion/Fuel Tank/Quick Disconnect/QDC-750x125FLG-270MB-O007-8NPT Quick Disconnect, Male, Mojave Sphinx.SLDPRT
19.1 x 19.1 x 19.1 mm
