Mines-Rocketry-Club/liquid-halfCat/CAD/Propulsion/Fuel Tank/SABV/SABV-HCON-04V-3225S Handle Connector, Servo Actuated Ball Valve, Mojave Sphinx.SLDPRT

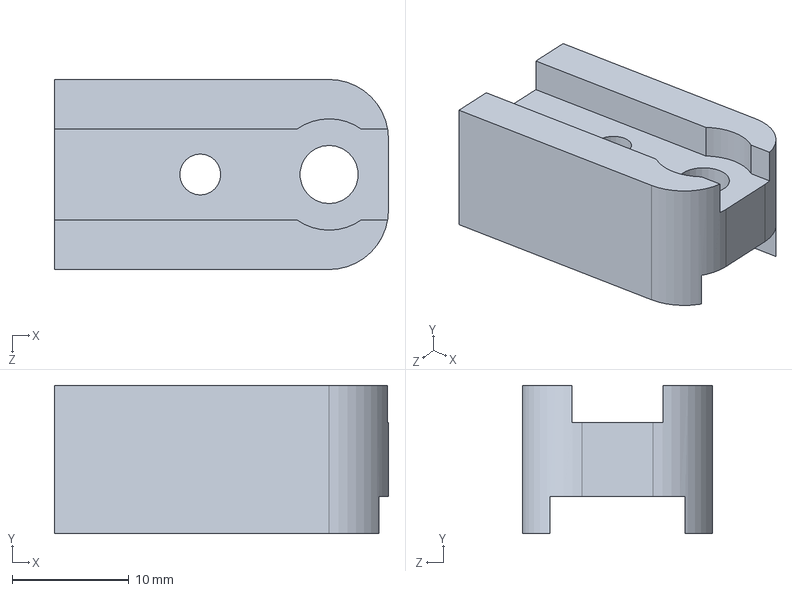
[picture p9: CAD file, 2025-05-20]
CAD/Propulsion/Fuel Tank/SABV/SABV-HCON-04V-3225S Handle Connector, Servo Actuated Ball Valve, Mojave Sphinx.SLDPRT
28.6 x 12.7 x 16.3 mm
