Mines-Rocketry-Club/liquid-halfCat/CAD/Propulsion/Igniter/Igniter Estes 13mm.SLDPRT

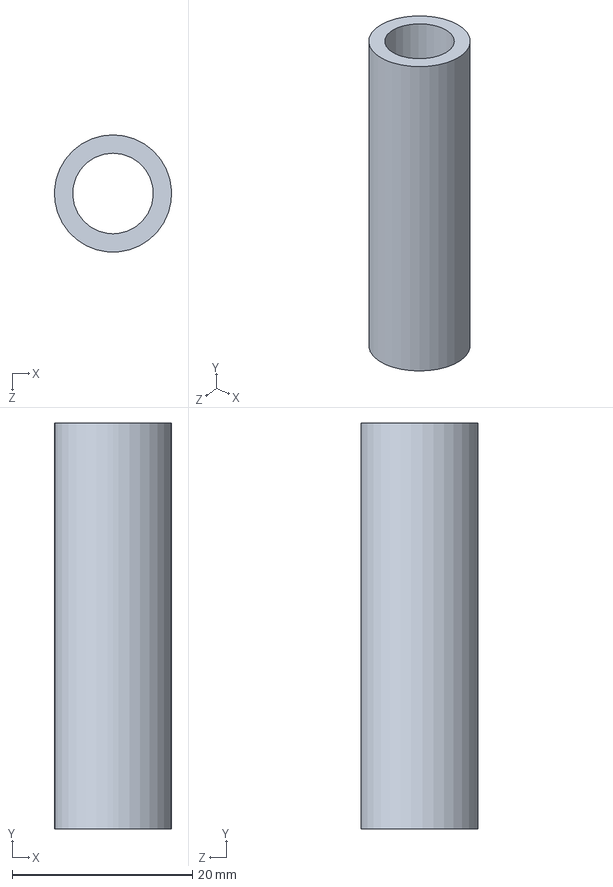
[picture p10: CAD file, 2025-05-20]
CAD/Propulsion/Igniter/Igniter Estes 13mm.SLDPRT
13.0 x 45.0 x 13.0 mm
