Mines-Rocketry-Club/liquid-halfCat/CAD/Propulsion/Thrust Chamber/Injector/INJC-2X8NPT-38NPT-250T20-2XO230-GENERIC Injector, Generic Orifice Pattern, Mojave Sphinx.SLDPRT

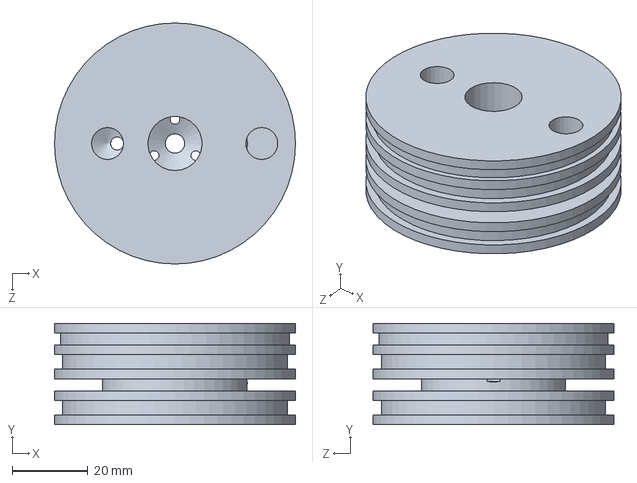
[picture p11: CAD file, 2025-09-30]
CAD/Propulsion/Thrust Chamber/Injector/INJC-2X8NPT-38NPT-250T20-2XO230-GENERIC Injector, Generic Orifice Pattern, Mojave Sphinx.SLDPRT
63.5 x 26.7 x 63.5 mm
