Mines-Rocketry-Club/liquid-halfCat/CAD/Propulsion/Thrust Chamber/Nozzle/THRT-45C20D-100T Throat Insert, Spring Retained, Mojave Sphinx.SLDPRT

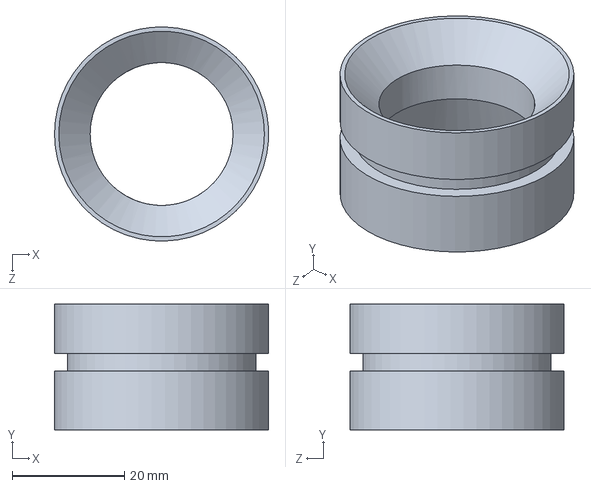
[picture p12: CAD file, 2025-09-24]
CAD/Propulsion/Thrust Chamber/Nozzle/THRT-45C20D-100T Throat Insert, Spring Retained, Mojave Sphinx.SLDPRT
38.1 x 22.4 x 38.1 mm
