Mines-Rocketry-Club/liquid-halfCat/CAD/Airframe/Avionics/AVBY-SB-4160 Switchband, Avbay, Mojave Sphinx.SLDPRT

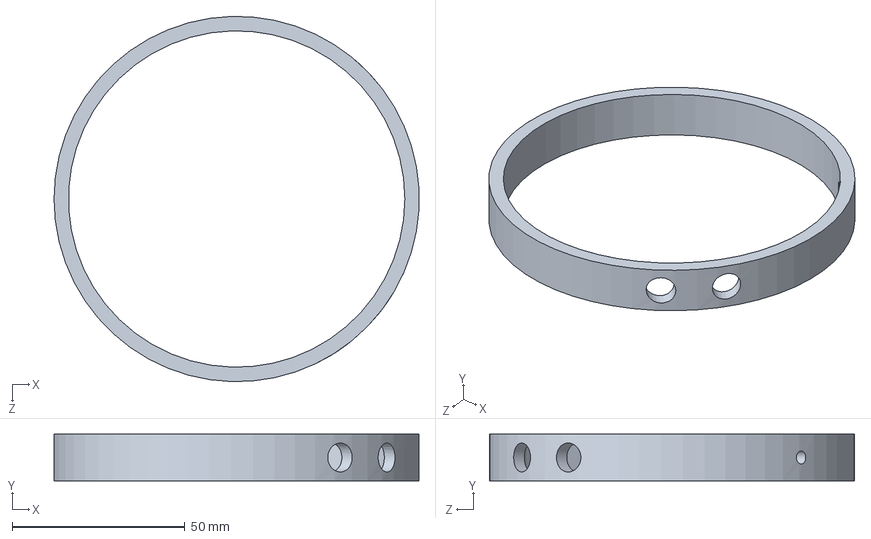
[picture p13: CAD file, 2025-05-20]
CAD/Airframe/Avionics/AVBY-SB-4160 Switchband, Avbay, Mojave Sphinx.SLDPRT
105.6 x 13.5 x 105.6 mm
