Mines-Rocketry-Club/liquid-halfCat/CAD/Airframe/Avionics/Avionics Sled/9V Battery.SLDPRT

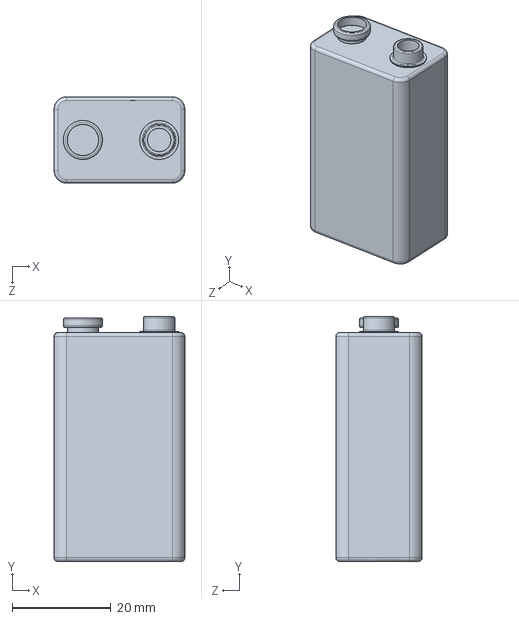
[picture p14: CAD file, 2025-05-20]
CAD/Airframe/Avionics/Avionics Sled/9V Battery.SLDPRT
26.5 x 49.7 x 17.5 mm
