Mines-Rocketry-Club/liquid-halfCat/CAD/Airframe/Fins/AERO-100X100X0125 Aerodynamic Fin Bracket Tip, for 1.00 X 1.00 X .125 Aluminum Angle, Mojave Sphinx.SLDPRT

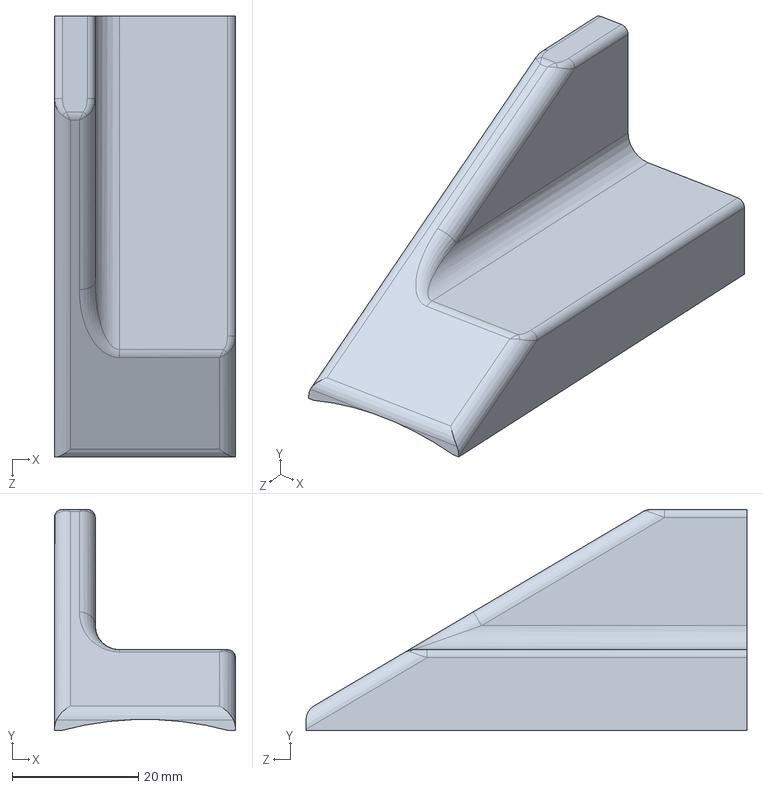
[picture p15: CAD file, 2026-02-24]
CAD/Airframe/Fins/AERO-100X100X0125 Aerodynamic Fin Bracket Tip, for 1.00 X 1.00 X .125 Aluminum Angle, Mojave Sphinx.SLDPRT
28.7 x 35.1 x 69.8 mm
