Mines-Rocketry-Club/liquid-halfCat/CAD/Airframe/Nose Cone/NSCN2.STEP

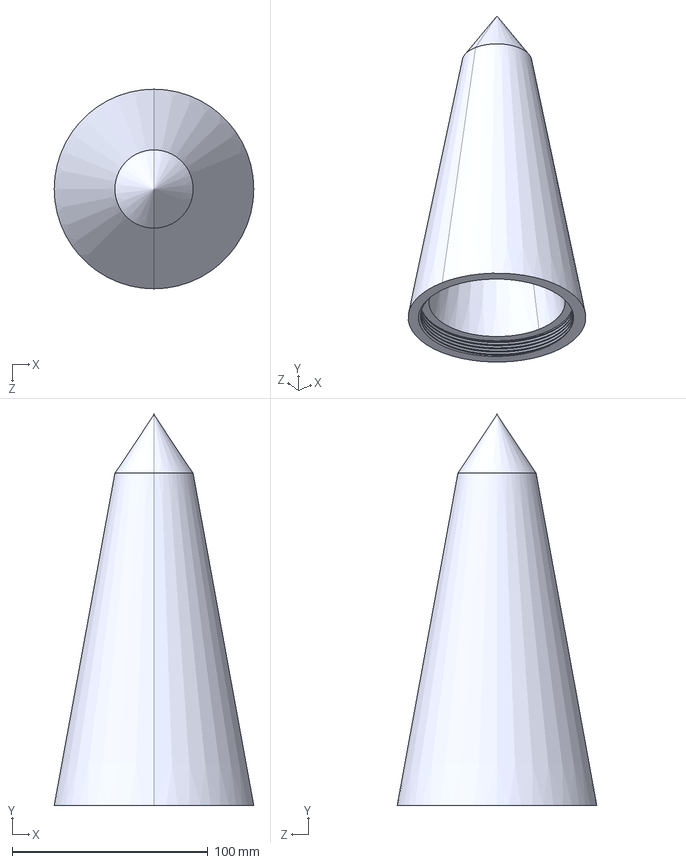
[picture p16: CAD file, 2025-10-13]
CAD/Airframe/Nose Cone/NSCN2.STEP
102.1 x 200.0 x 102.1 mm
