Mines-Rocketry-Club/liquid-halfCat/CAD/Airframe/PLG-DRL-AF-UPR1-416 Backing Plug, Sacrificial, for Upper Airframe Tube Drilling.SLDPRT

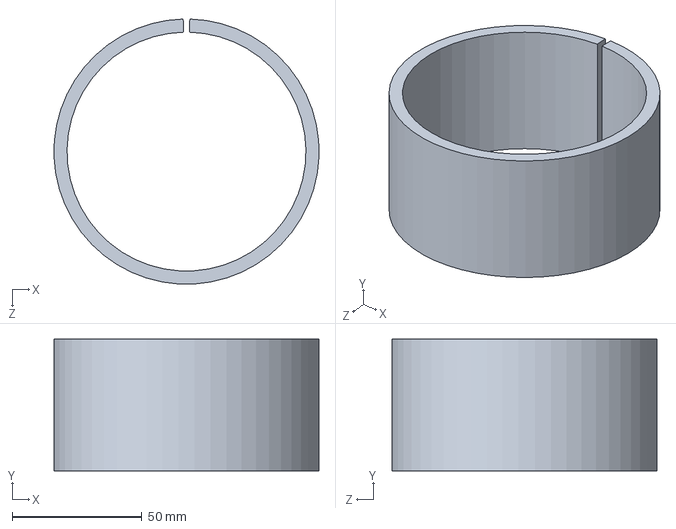
[picture p17: CAD file, 2025-05-20]
CAD/Airframe/PLG-DRL-AF-UPR1-416 Backing Plug, Sacrificial, for Upper Airframe Tube Drilling.SLDPRT
102.3 x 50.8 x 102.3 mm
