Mines-Rocketry-Club/liquid-halfCat/CAD/Airframe/Recovery/REC-CHT-DRG-36, Parachute, Drogue, 36 Inch, Mass Volume, Mojave Sphinx.SLDPRT

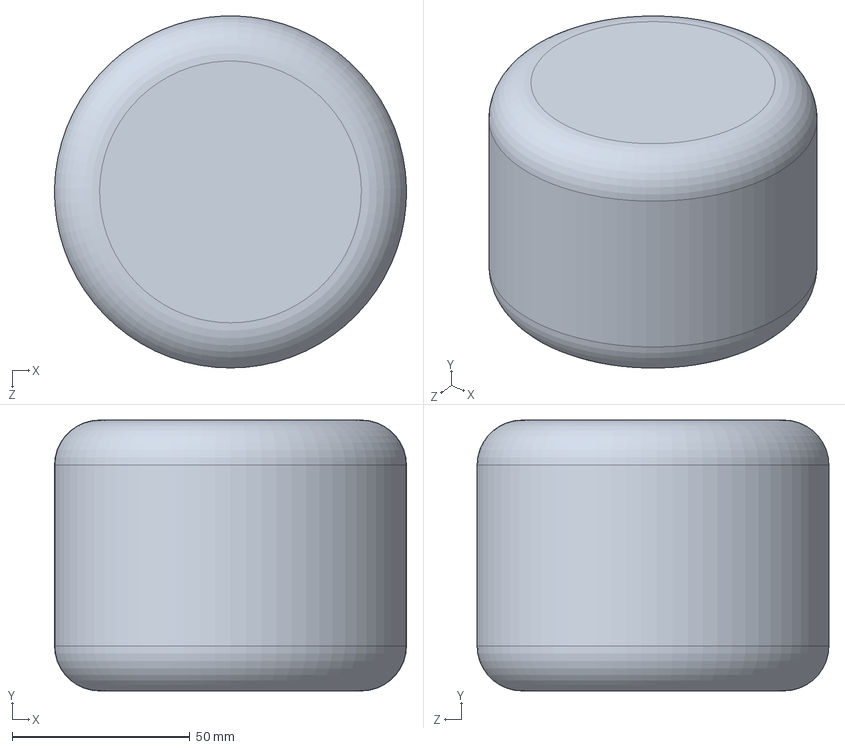
[picture p18: CAD file, 2025-05-20]
CAD/Airframe/Recovery/REC-CHT-DRG-36, Parachute, Drogue, 36 Inch, Mass Volume, Mojave Sphinx.SLDPRT
99.0 x 76.2 x 99.0 mm
