Mines-Rocketry-Club/liquid-halfCat/CAD/Propulsion/Fuel Tank/PSTN-2XO238-250T20 Propellant Piston, Mojave Sphinx.SLDPRT

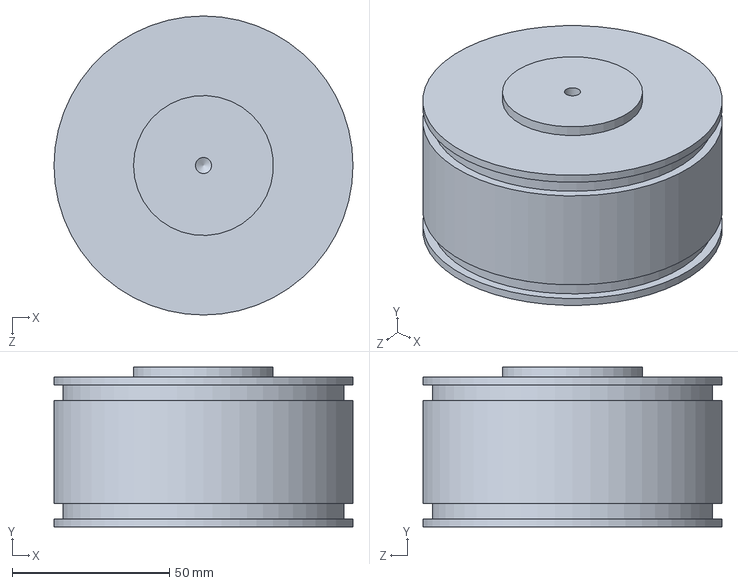
[picture p19: CAD file, 2025-09-22]
CAD/Propulsion/Fuel Tank/PSTN-2XO238-250T20 Propellant Piston, Mojave Sphinx.SLDPRT
95.0 x 50.8 x 95.0 mm
