Mines-Rocketry-Club/liquid-halfCat/CAD/Propulsion/Fuel Tank/Quick Disconnect/QDC-750X125FLG-281FB-8NPT Quick Disconnect, Female, Mojave Sphinx.SLDPRT

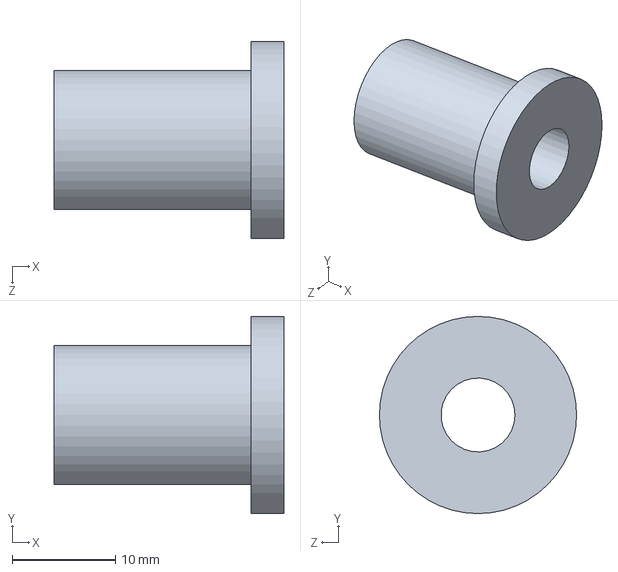
[picture p20: CAD file, 2025-09-22]
CAD/Propulsion/Fuel Tank/Quick Disconnect/QDC-750X125FLG-281FB-8NPT Quick Disconnect, Female, Mojave Sphinx.SLDPRT
22.2 x 19.1 x 19.1 mm
