Mines-Rocketry-Club/liquid-halfCat/CAD/Propulsion/Fuel Tank/SABV/DS3225 Servo 25kg-cm.SLDPRT

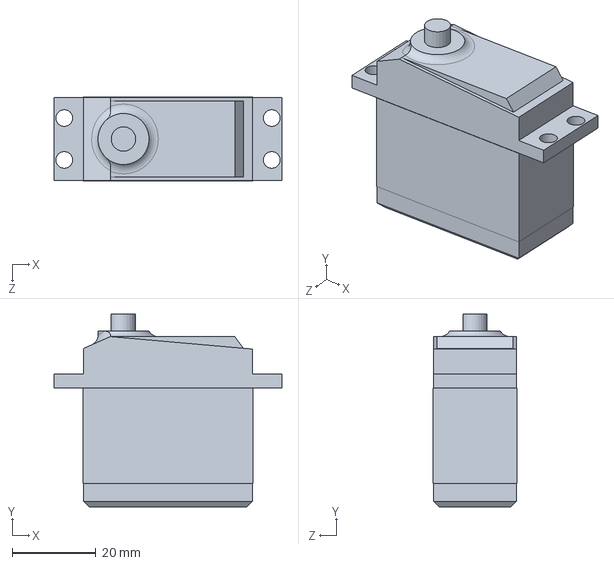
[picture p21: CAD file, 2025-05-20]
CAD/Propulsion/Fuel Tank/SABV/DS3225 Servo 25kg-cm.SLDPRT
54.4 x 46.0 x 19.9 mm
