Mines-Rocketry-Club/liquid-halfCat/CAD/Propulsion/Thrust Chamber/Flat pattern - BRKT-90A-125T-2X250C Bracket, Thrust Chamber Mounting, Mojave Sphinx.DXF

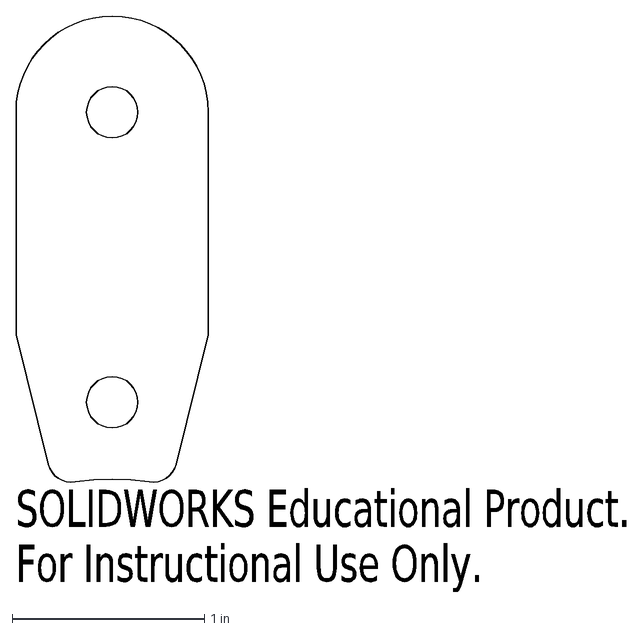
[picture p22: CAD file, 2025-10-13]
CAD/Propulsion/Thrust Chamber/Flat pattern - BRKT-90A-125T-2X250C Bracket, Thrust Chamber Mounting, Mojave Sphinx.DXF
SOLIDWORKS Educational Product.
For Instructional Use Only.
