Mines-Rocketry-Club/liquid-halfCat/CAD/Airframe/Fins/TMPLT-FIN-BRKT-1X1-AFT.SLDPRT

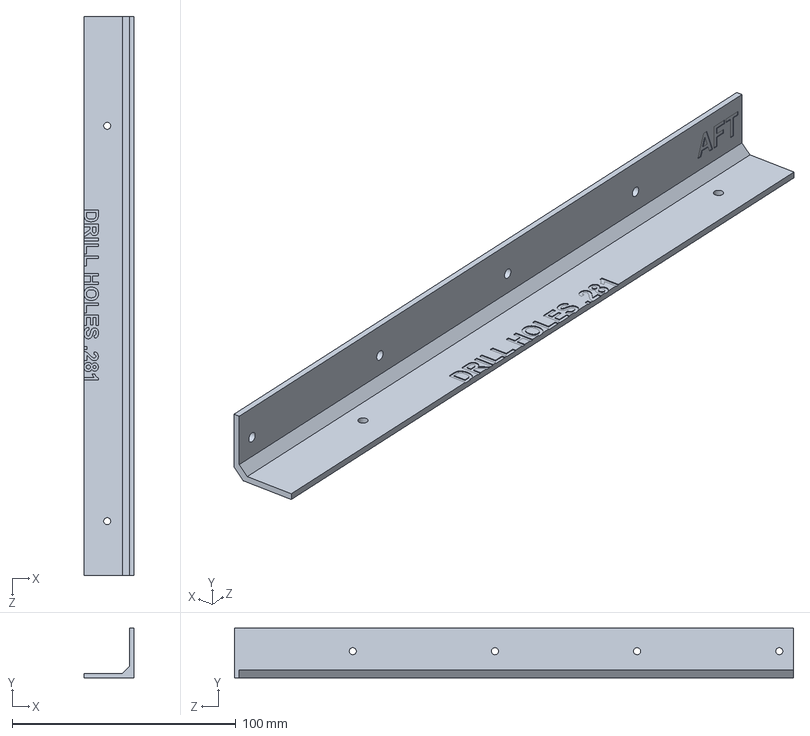
[picture p23: CAD file, 2025-05-20]
CAD/Airframe/Fins/TMPLT-FIN-BRKT-1X1-AFT.SLDPRT
22.2 x 22.2 x 249.7 mm
