Mines-Rocketry-Club/liquid-halfCat/CAD/Airframe/TMPLT-AF-UPR-416 Template, Hole Marking, Upper Airframe Tube, Mojave Sphinx.SLDPRT

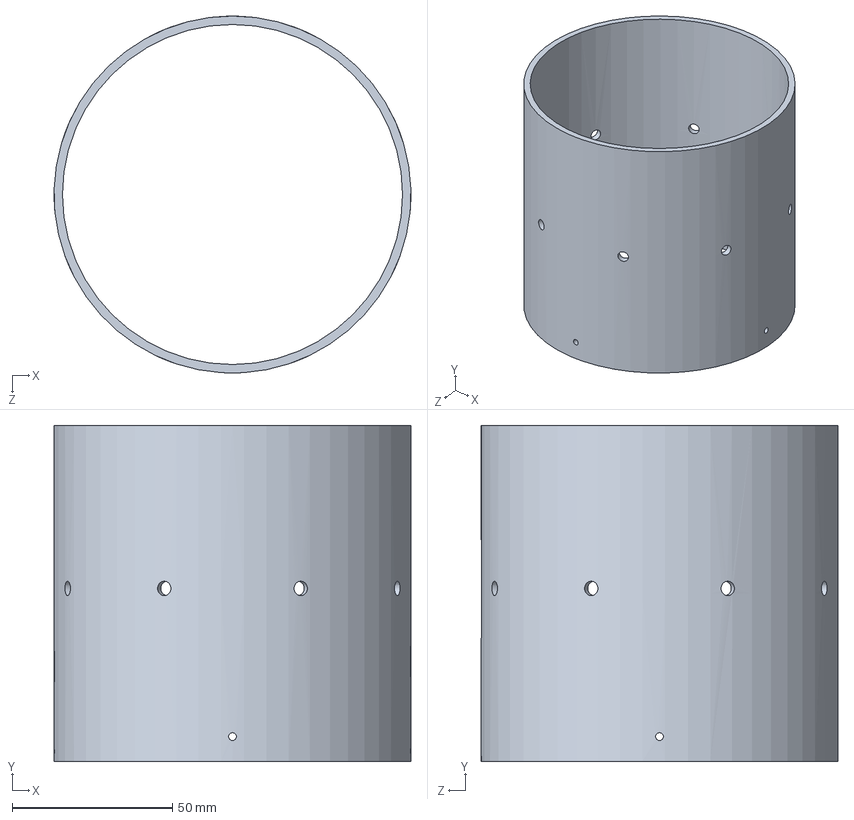
[picture p24: CAD file, 2025-05-20]
CAD/Airframe/TMPLT-AF-UPR-416 Template, Hole Marking, Upper Airframe Tube, Mojave Sphinx.SLDPRT
111.3 x 104.8 x 111.3 mm
