Mines-Rocketry-Club/liquid-halfCat/CAD/Propulsion/Fuel Tank/Quick Disconnect/QDC-750X250CLP Quick Disconnect, Clip, Mojave Sphinx.SLDPRT

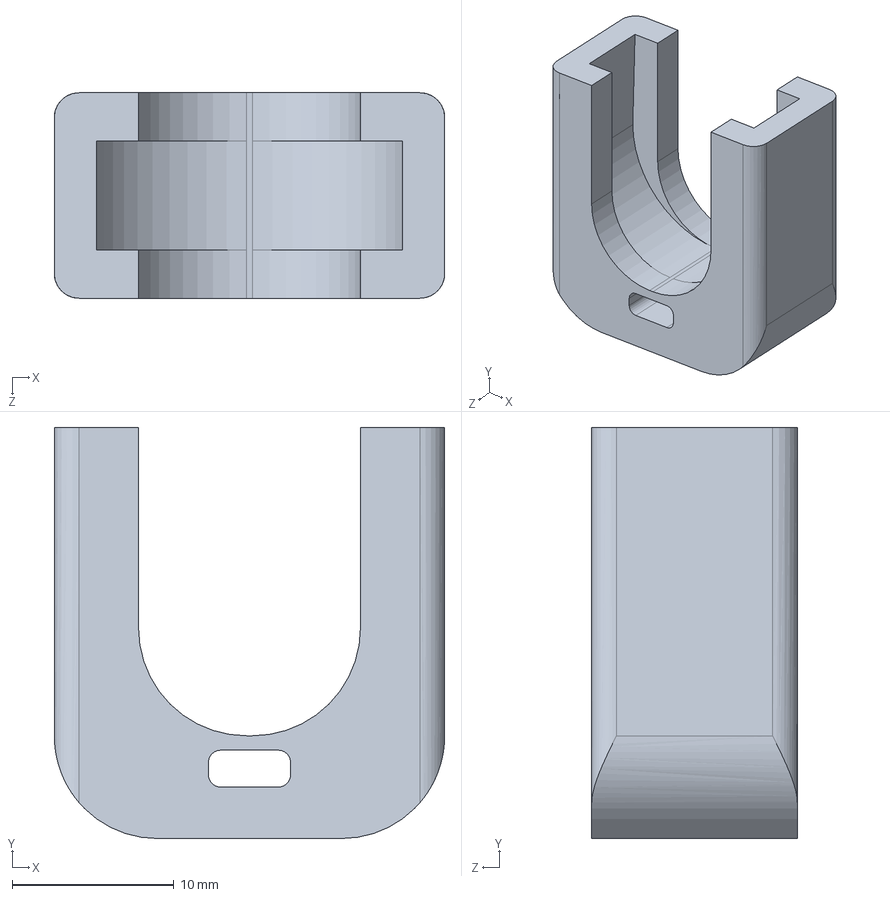
[picture p25: CAD file, 2025-05-20]
CAD/Propulsion/Fuel Tank/Quick Disconnect/QDC-750X250CLP Quick Disconnect, Clip, Mojave Sphinx.SLDPRT
24.1 x 25.4 x 12.7 mm
