Mines-Rocketry-Club/liquid-halfCat/CAD/Propulsion/Fuel Tank/SABV/SABV-MNT-04V-3225S Mount, Servo Actuated Ball Valve, Hex Clearance, Mojave Sphinx.SLDPRT

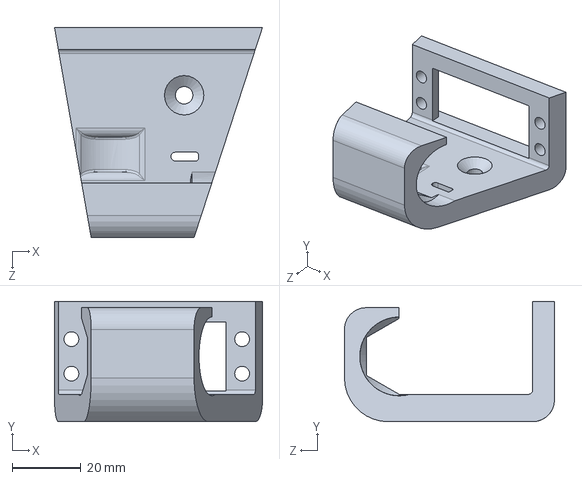
[picture p26: CAD file, 2025-05-20]
CAD/Propulsion/Fuel Tank/SABV/SABV-MNT-04V-3225S Mount, Servo Actuated Ball Valve, Hex Clearance, Mojave Sphinx.SLDPRT
60.3 x 34.9 x 60.9 mm
