Mines-Rocketry-Club/liquid-halfCat/CAD/Propulsion/Thrust Chamber/CMBR-200DI-250B-525L Combustion Chamber, Mojave Sphinx.SLDPRT

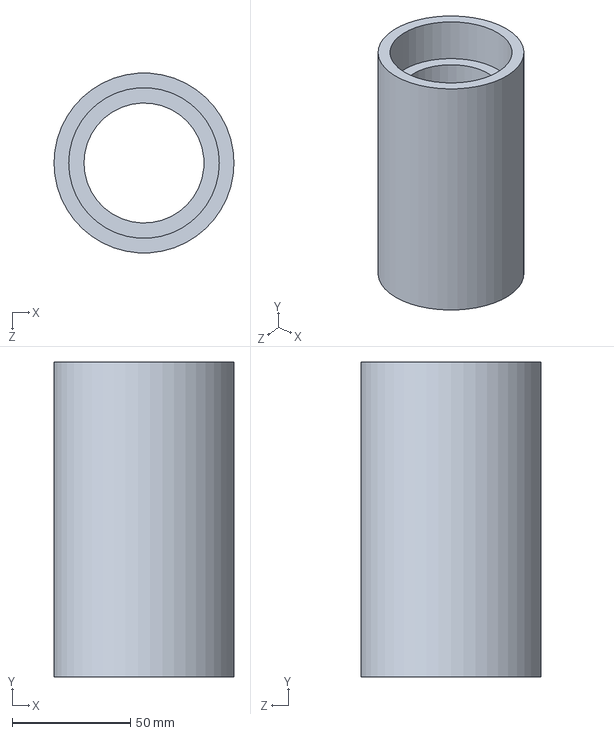
[picture p27: CAD file, 2025-09-30]
CAD/Propulsion/Thrust Chamber/CMBR-200DI-250B-525L Combustion Chamber, Mojave Sphinx.SLDPRT
76.2 x 133.4 x 76.0 mm
