Mines-Rocketry-Club/liquid-halfCat/CAD/Propulsion/Thrust Chamber/Nozzle/NZZL-45C20D-200E Nozzle, for Throat Insert, Mojave Sphinx.SLDPRT

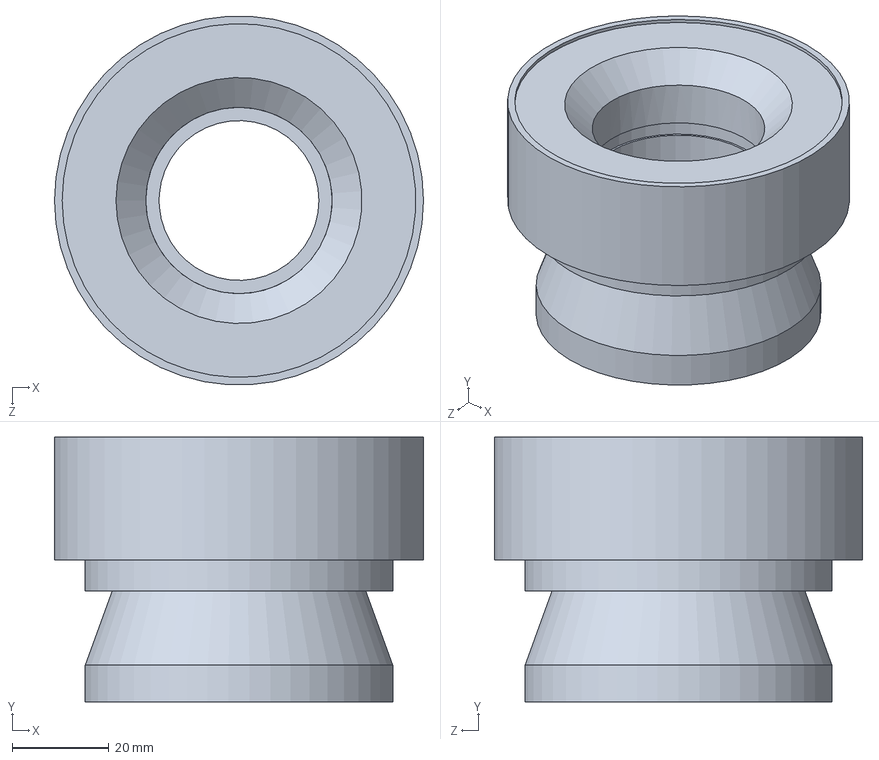
[picture p28: CAD file, 2025-05-20]
CAD/Propulsion/Thrust Chamber/Nozzle/NZZL-45C20D-200E Nozzle, for Throat Insert, Mojave Sphinx.SLDPRT
76.2 x 54.7 x 76.0 mm
