Mines-Rocketry-Club/liquid-halfCat/CAD/Airframe/Avionics/Avionics Sled/AVBY-MT-250R-M4C Mount, Avbay Sled, Mojave Sphinx.SLDPRT

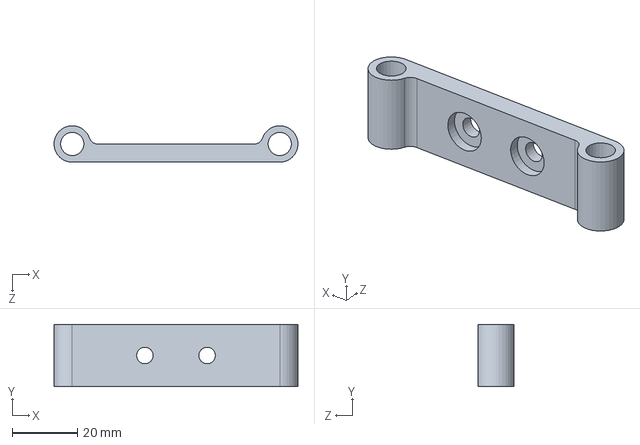
[picture p29: CAD file, 2025-05-20]
CAD/Airframe/Avionics/Avionics Sled/AVBY-MT-250R-M4C Mount, Avbay Sled, Mojave Sphinx.SLDPRT
74.7 x 19.1 x 11.2 mm
