Mines-Rocketry-Club/liquid-halfCat/CAD/Airframe/Avionics/BKHD-REC-4X250C-2X170WE Bulkhead, Recovery and Avionics Bay, Mojave Sphinx.SLDPRT

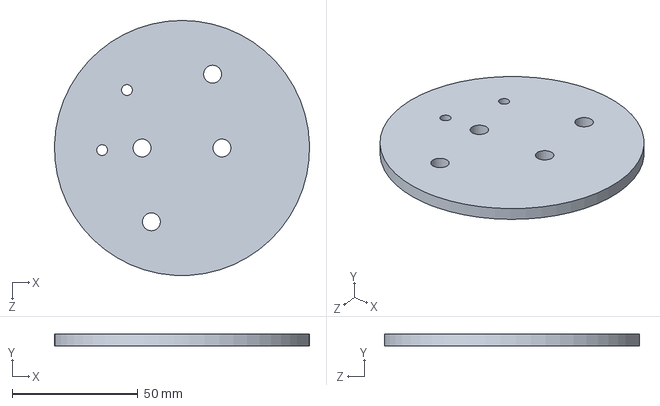
[picture p30: CAD file, 2025-05-20]
CAD/Airframe/Avionics/BKHD-REC-4X250C-2X170WE Bulkhead, Recovery and Avionics Bay, Mojave Sphinx.SLDPRT
101.3 x 4.78 x 101.3 mm
