Mines-Rocketry-Club/liquid-halfCat/CAD/Airframe/Nose Cone/NSCN-SLDR-4X250R-8X832HNC Nose Cone Shoulder, Mojave Sphinx.SLDPRT

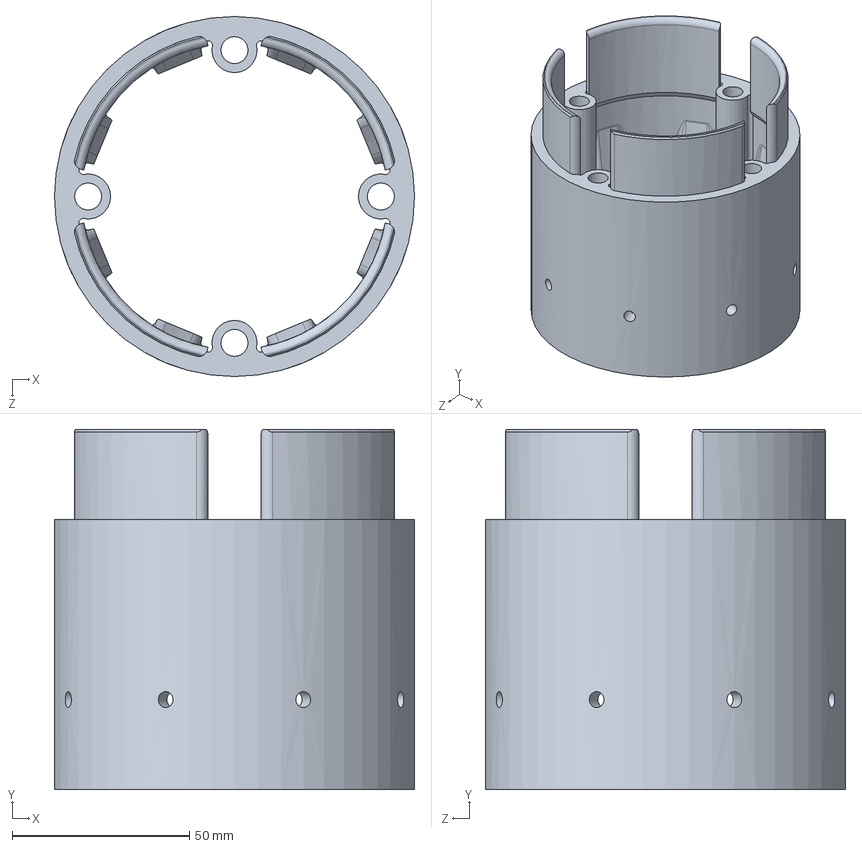
[picture p31: CAD file, 2025-05-20]
CAD/Airframe/Nose Cone/NSCN-SLDR-4X250R-8X832HNC Nose Cone Shoulder, Mojave Sphinx.SLDPRT
101.5 x 101.6 x 101.5 mm
