Mines-Rocketry-Club/liquid-halfCat/CAD/Airframe/RLBTN-B-1515-250C Rail Button, 1515, Part B, Mojave Sphinx.SLDPRT

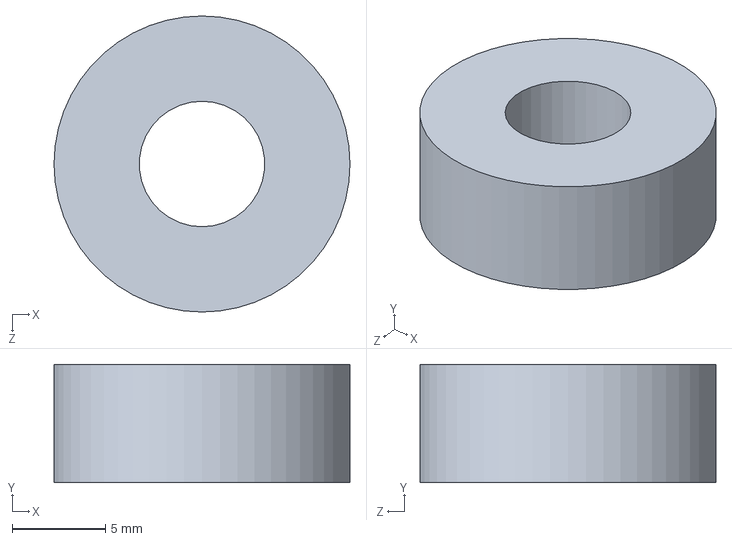
[picture p32: CAD file, 2025-05-20]
CAD/Airframe/RLBTN-B-1515-250C Rail Button, 1515, Part B, Mojave Sphinx.SLDPRT
15.9 x 6.35 x 15.9 mm
