Mines-Rocketry-Club/liquid-halfCat/CAD/Propulsion/Fuel Tank/SABV/25T Servo Horn.SLDPRT

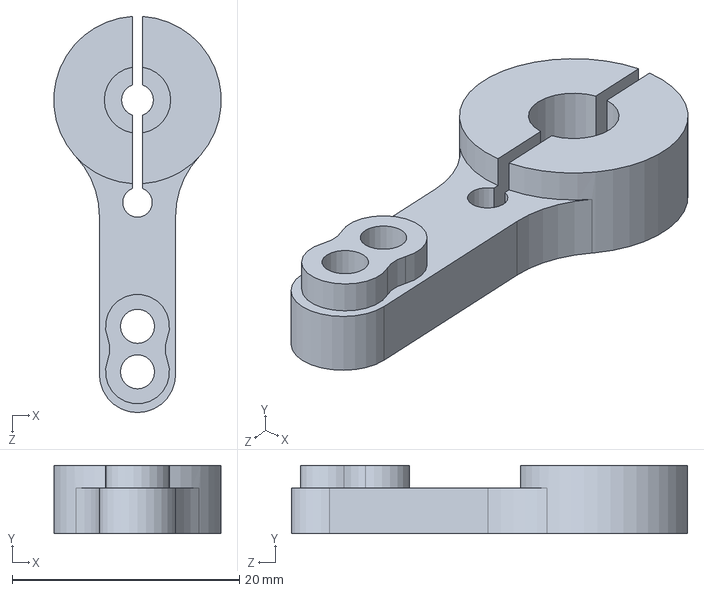
[picture p33: CAD file, 2025-05-20]
CAD/Propulsion/Fuel Tank/SABV/25T Servo Horn.SLDPRT
14.7 x 6.00 x 34.8 mm
