Mines-Rocketry-Club/liquid-halfCat/CAD/Propulsion/Thrust Chamber/FLNG-ST-25T-8X250C Flange Plate, Thrust Chamber, Mojave Sphinx.SLDPRT

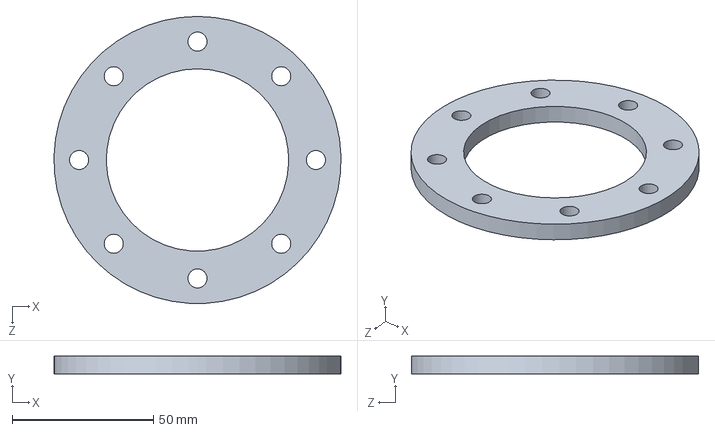
[picture p34: CAD file, 2025-05-20]
CAD/Propulsion/Thrust Chamber/FLNG-ST-25T-8X250C Flange Plate, Thrust Chamber, Mojave Sphinx.SLDPRT
101.6 x 6.35 x 101.6 mm
