Mines-Rocketry-Club/liquid-halfCat/CAD/Airframe/Avionics/AVBY-CR-4R Bulkhead Centering Ring, Avbay, Mojave Sphinx.SLDPRT

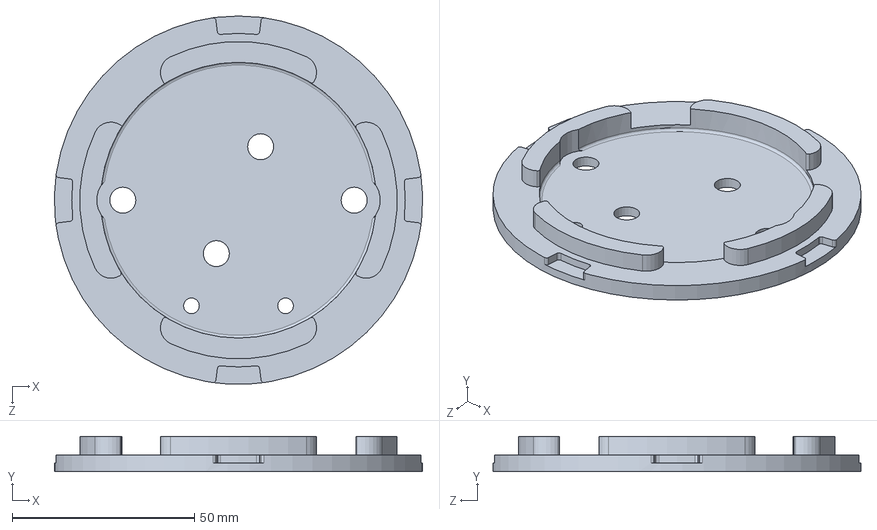
[picture p35: CAD file, 2025-05-20]
CAD/Airframe/Avionics/AVBY-CR-4R Bulkhead Centering Ring, Avbay, Mojave Sphinx.SLDPRT
101.0 x 9.65 x 101.0 mm
