Mines-Rocketry-Club/liquid-halfCat/CAD/Airframe/Fins/FIN-STD-250T-4X250C Fin, Standard, Mojave Sphinx.SLDPRT

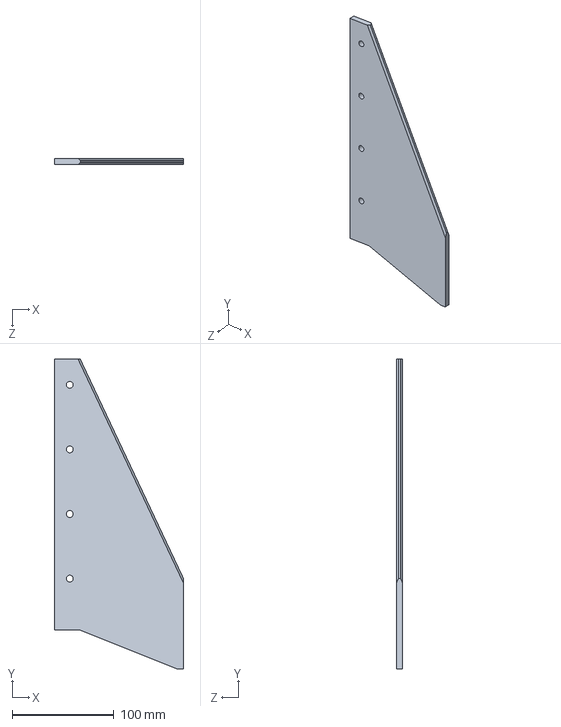
[picture p36: CAD file, 2025-05-20]
CAD/Airframe/Fins/FIN-STD-250T-4X250C Fin, Standard, Mojave Sphinx.SLDPRT
127.0 x 304.8 x 6.35 mm
