Mines-Rocketry-Club/liquid-halfCat/CAD/Airframe/Nose Cone/NSCN-TIP-4X250R-250HNC Nose Cone Tip, Mojave Sphinx.SLDPRT

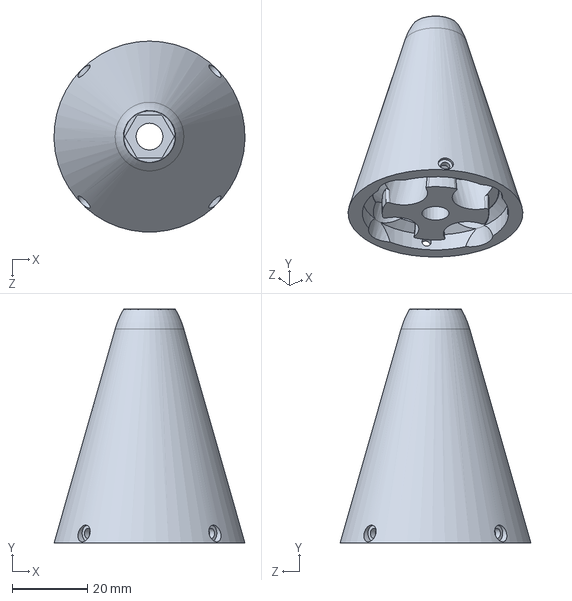
[picture p37: CAD file, 2025-05-20]
CAD/Airframe/Nose Cone/NSCN-TIP-4X250R-250HNC Nose Cone Tip, Mojave Sphinx.SLDPRT
50.8 x 62.2 x 50.7 mm
