Mines-Rocketry-Club/liquid-halfCat/CAD/Airframe/Recovery/REC-TNSC-3KLB-25FT Shock Cord, 25FT, Mass Volume, Mojave Sphinx.SLDPRT

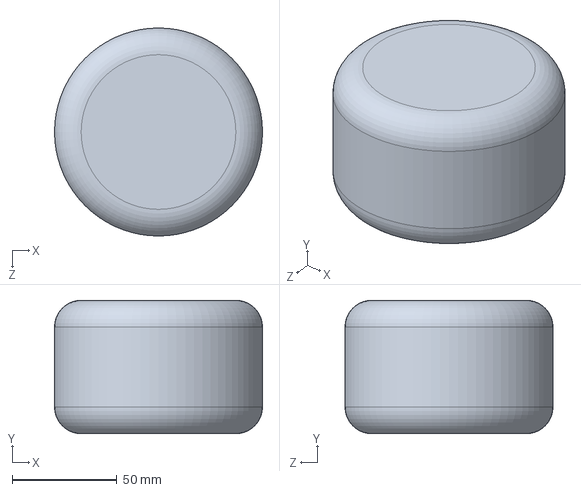
[picture p38: CAD file, 2025-05-20]
CAD/Airframe/Recovery/REC-TNSC-3KLB-25FT Shock Cord, 25FT, Mass Volume, Mojave Sphinx.SLDPRT
99.1 x 63.5 x 99.1 mm
