Mines-Rocketry-Club/liquid-halfCat/CAD/Airframe/RLBTN-A-1515-250C Rail Button, 1515, Part A, Mojave Sphinx.SLDPRT

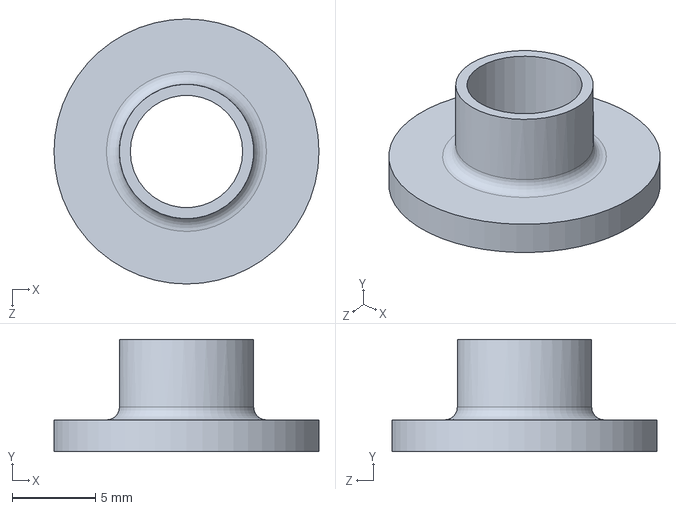
[picture p39: CAD file, 2025-05-20]
CAD/Airframe/RLBTN-A-1515-250C Rail Button, 1515, Part A, Mojave Sphinx.SLDPRT
15.9 x 6.73 x 15.9 mm
