Mines-Rocketry-Club/liquid-halfCat/CAD/Propulsion/Fuel Tank/INRG-200S-8X3125C-8X250C Interface Ring, Tank, Mojave Sphinx.SLDPRT

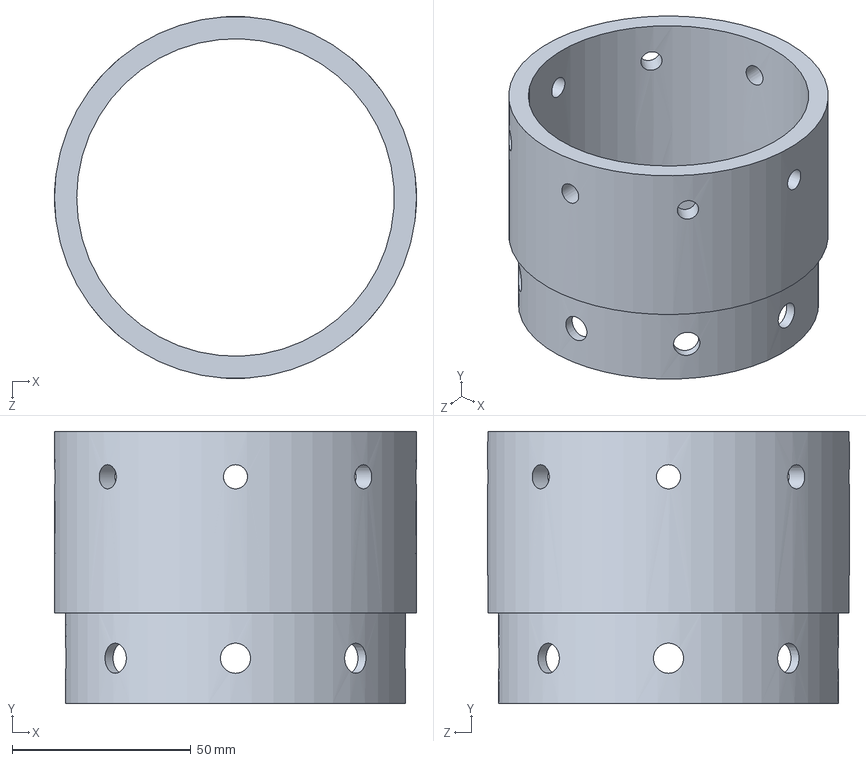
[picture p40: CAD file, 2025-05-20]
CAD/Propulsion/Fuel Tank/INRG-200S-8X3125C-8X250C Interface Ring, Tank, Mojave Sphinx.SLDPRT
101.3 x 76.2 x 101.3 mm
