Mines-Rocketry-Club/liquid-halfCat/CAD/Propulsion/Thrust Chamber/BRKT-90A-125T-2X250C Bracket, Thrust Chamber Mounting, Mojave Sphinx.SLDPRT

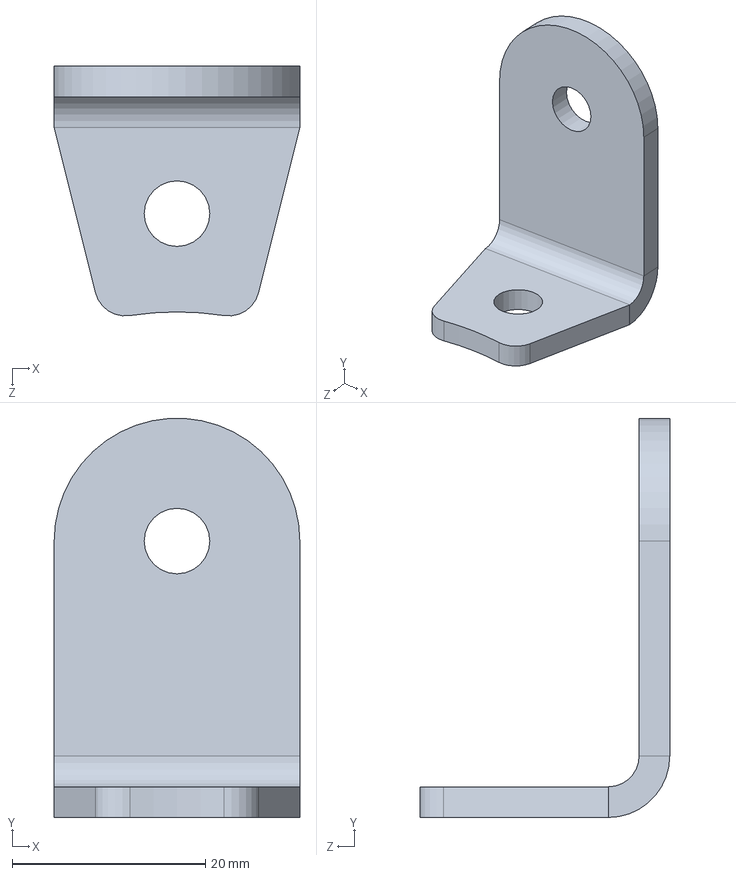
[picture p41: CAD file, 2025-05-20]
CAD/Propulsion/Thrust Chamber/BRKT-90A-125T-2X250C Bracket, Thrust Chamber Mounting, Mojave Sphinx.SLDPRT
25.4 x 41.2 x 25.8 mm
