Mines-Rocketry-Club/liquid-halfCat/CAD/Airframe/Avionics/Avionics Sled/AVBY-BH-2X9V-250R-M4C Battery Holder, Avbay, Mojave Sphinx.SLDPRT

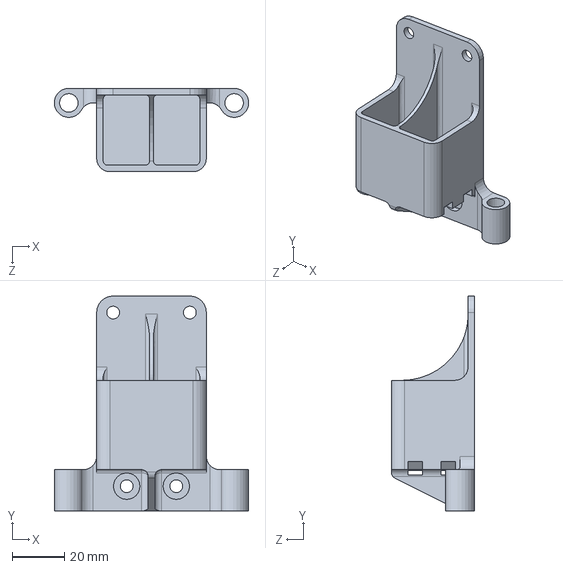
[picture p42: CAD file, 2025-05-20]
CAD/Airframe/Avionics/Avionics Sled/AVBY-BH-2X9V-250R-M4C Battery Holder, Avbay, Mojave Sphinx.SLDPRT
74.6 x 82.6 x 32.0 mm
