Mines-Rocketry-Club/liquid-halfCat/CAD/Airframe/Fins/TMPLT-FIN-BRKT-1X1-FWD.SLDPRT

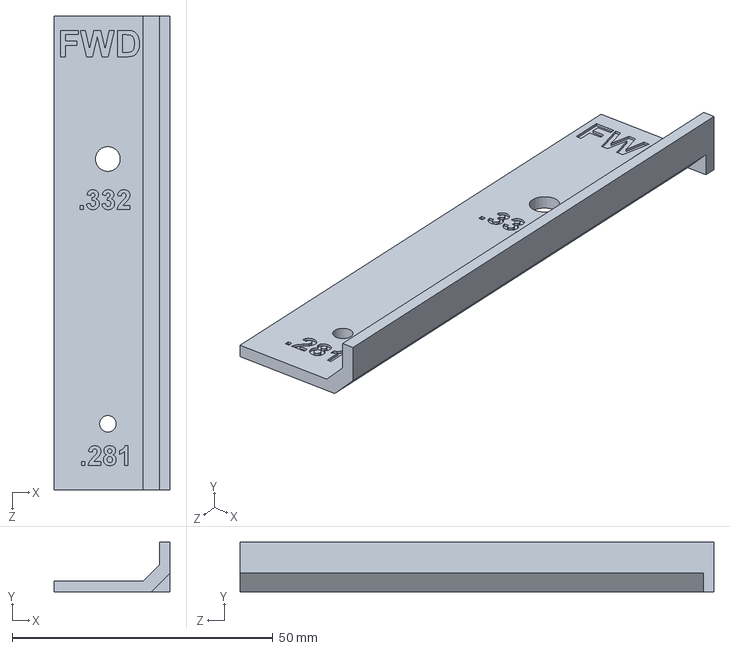
[picture p43: CAD file, 2025-05-20]
CAD/Airframe/Fins/TMPLT-FIN-BRKT-1X1-FWD.SLDPRT
22.2 x 9.53 x 90.9 mm
