Mines-Rocketry-Club/liquid-halfCat/CAD/Airframe/Avionics/Avionics Sled/EggTimer Quark.SLDPRT

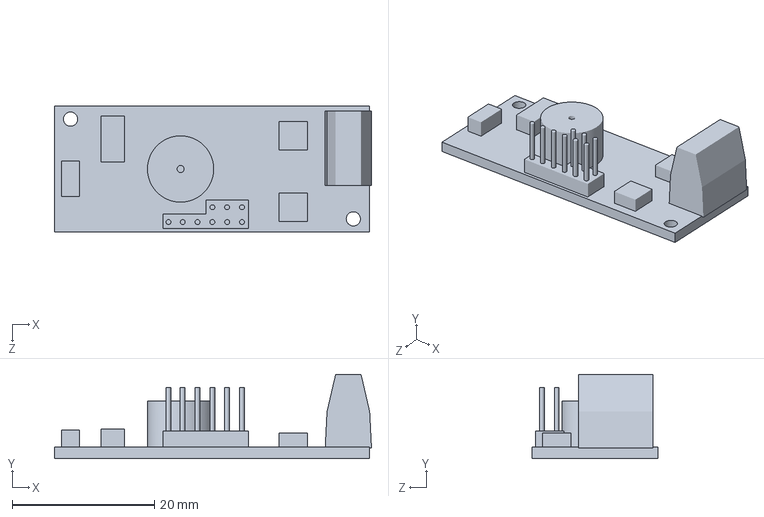
[picture p44: CAD file, 2025-05-20]
CAD/Airframe/Avionics/Avionics Sled/EggTimer Quark.SLDPRT
44.5 x 11.8 x 17.7 mm
