Mines-Rocketry-Club/liquid-halfCat/CAD/Airframe/Fins/SPCR-400SD-250C-313C Spacer, Fin Bracket to Tank, Mojave Sphinx.SLDPRT

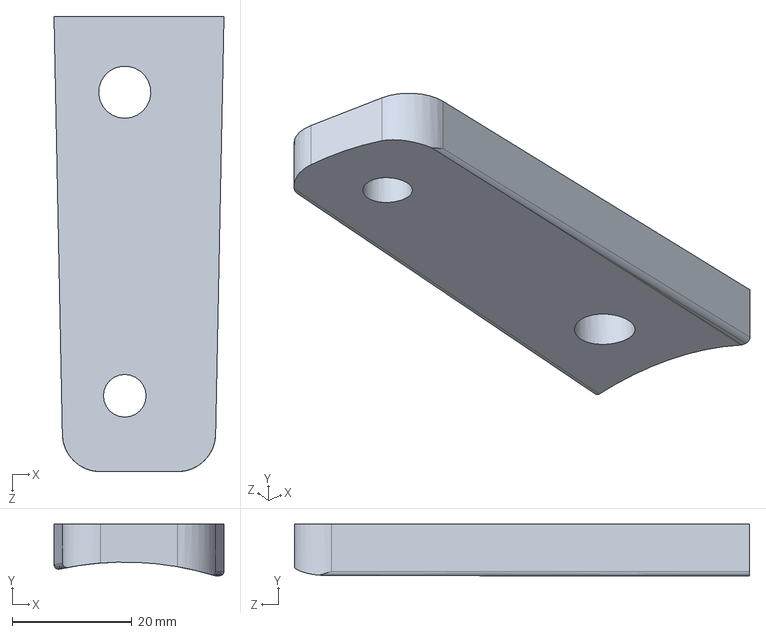
[picture p45: CAD file, 2025-05-20]
CAD/Airframe/Fins/SPCR-400SD-250C-313C Spacer, Fin Bracket to Tank, Mojave Sphinx.SLDPRT
28.4 x 8.64 x 76.2 mm
