Mines-Rocketry-Club/liquid-halfCat/CAD/Airframe/Nose Cone/NSCN-SC2-4X250R Nose Cone, Section 2, Mojave Sphinx.SLDPRT

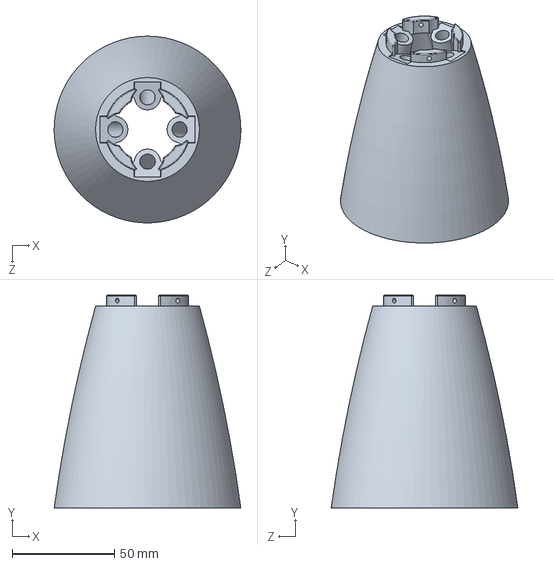
[picture p46: CAD file, 2025-05-20]
CAD/Airframe/Nose Cone/NSCN-SC2-4X250R Nose Cone, Section 2, Mojave Sphinx.SLDPRT
91.4 x 104.3 x 91.4 mm
