Mines-Rocketry-Club/liquid-halfCat/CAD/Propulsion/Fuel Tank/TANK-36L-047V-2X8X313C Tank Tube, Drilled, Mojave Sphinx.SLDPRT

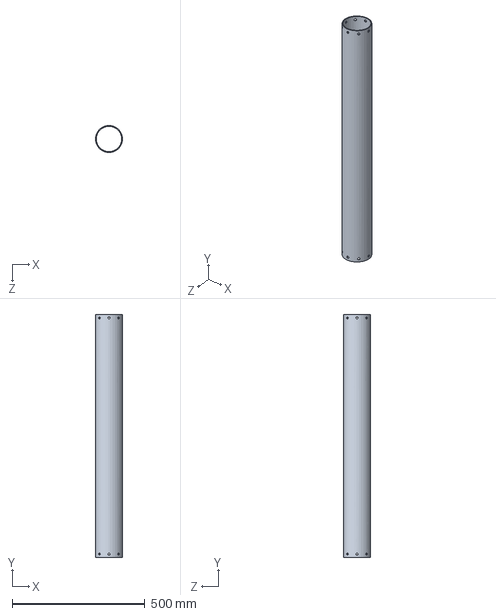
[picture p47: CAD file, 2025-05-20]
CAD/Propulsion/Fuel Tank/TANK-36L-047V-2X8X313C Tank Tube, Drilled, Mojave Sphinx.SLDPRT
101.6 x 914.4 x 101.6 mm
