Mines-Rocketry-Club/liquid-halfCat/CAD/Airframe/Nose Cone/NSCN-SC1-4X250R Nose Cone, Section 1, Mojave Sphinx.SLDPRT

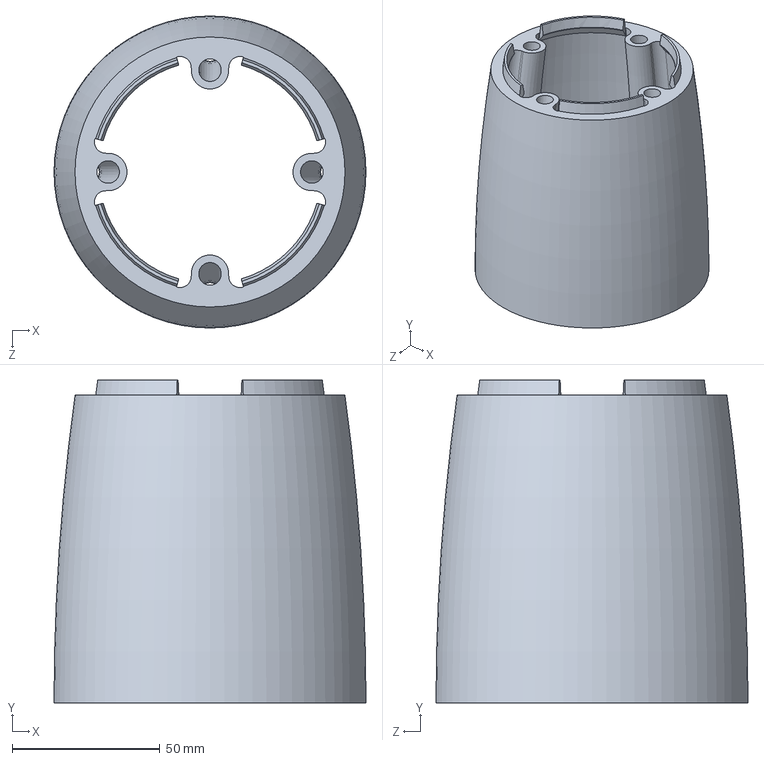
[picture p48: CAD file, 2025-05-20]
CAD/Airframe/Nose Cone/NSCN-SC1-4X250R Nose Cone, Section 1, Mojave Sphinx.SLDPRT
105.7 x 109.3 x 105.7 mm
