Mines-Rocketry-Club/liquid-halfCat/CAD/Airframe/TMPLT-AF-LWR-416 Template, for Holes and Slot, Airframe Tube, Lower, Mojave Sphinx.SLDPRT

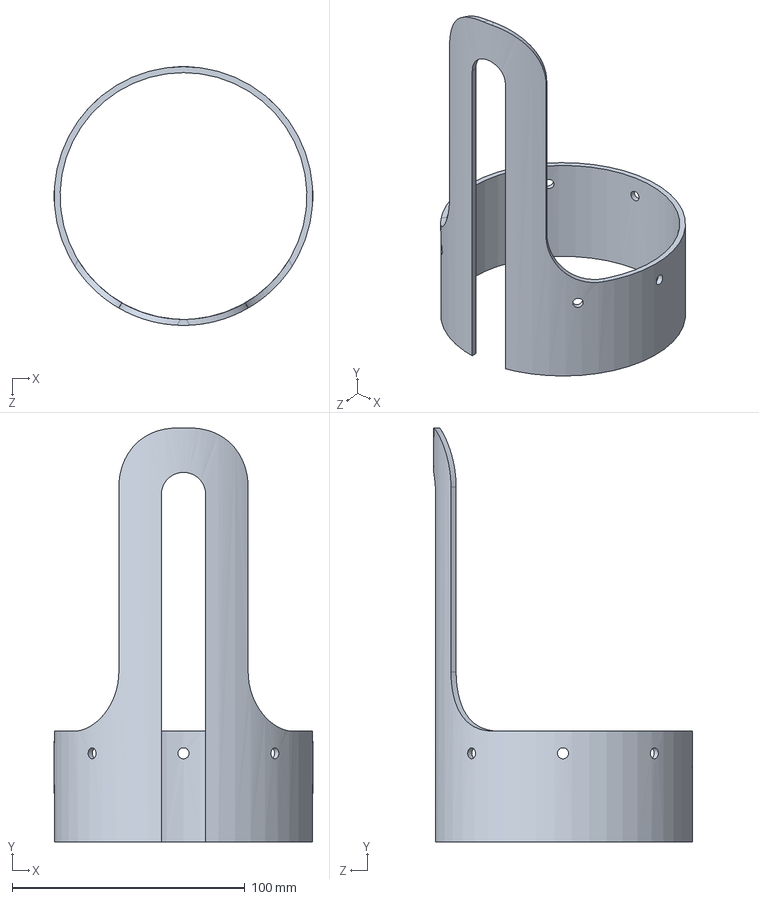
[picture p49: CAD file, 2025-05-20]
CAD/Airframe/TMPLT-AF-LWR-416 Template, for Holes and Slot, Airframe Tube, Lower, Mojave Sphinx.SLDPRT
111.1 x 177.8 x 111.1 mm
