Mines-Rocketry-Club/liquid-halfCat/CAD/Propulsion/Fuel Tank/DRLJG-TANK-8X625OD-BSHNG.SLDPRT

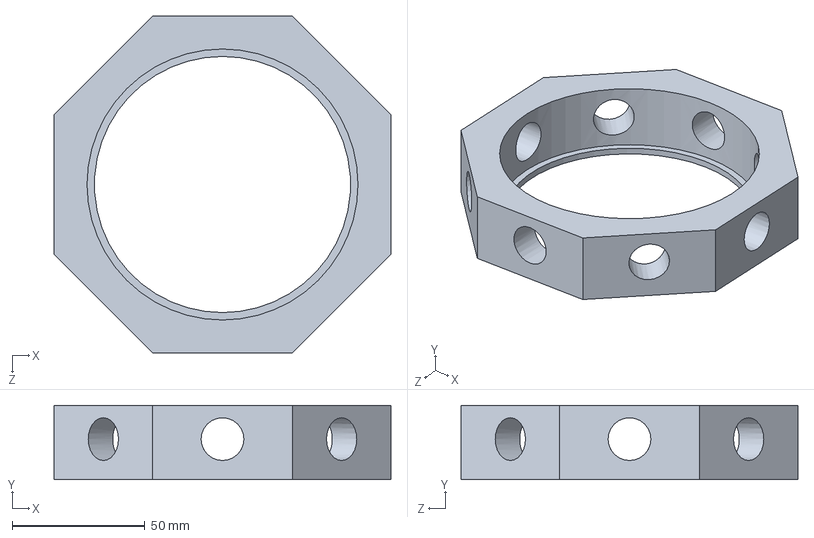
[picture p50: CAD file, 2025-05-20]
CAD/Propulsion/Fuel Tank/DRLJG-TANK-8X625OD-BSHNG.SLDPRT
127.0 x 27.9 x 127.0 mm
