Mines-Rocketry-Club/liquid-halfCat/CAD/Fittings/9685T3 QD Tube, 3.75in, Mojave Sphinx.SLDPRT

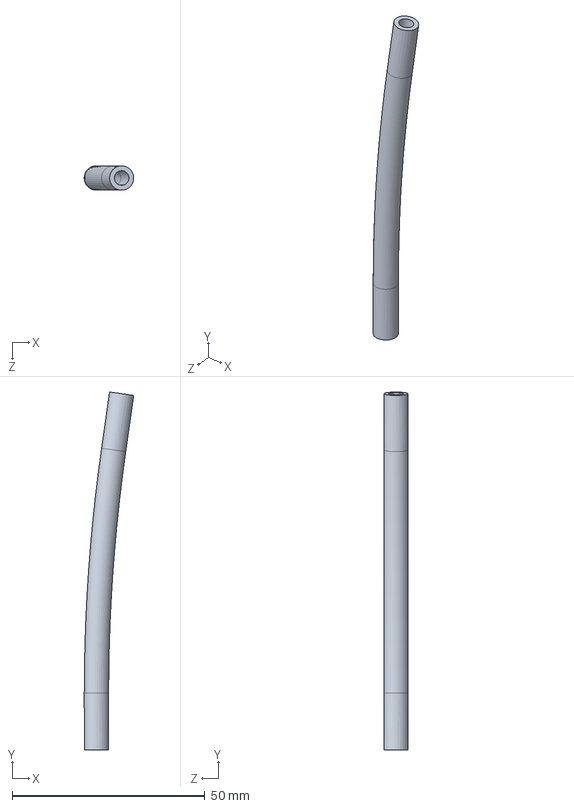
[picture p51: CAD file, 2025-05-20]
CAD/Fittings/9685T3 QD Tube, 3.75in, Mojave Sphinx.SLDPRT
12.9 x 92.9 x 6.35 mm
