Mines-Rocketry-Club/liquid-halfCat/CAD/Airframe/Fins/Mojave Sphinx Fin Bracket Assembly.SLDASM

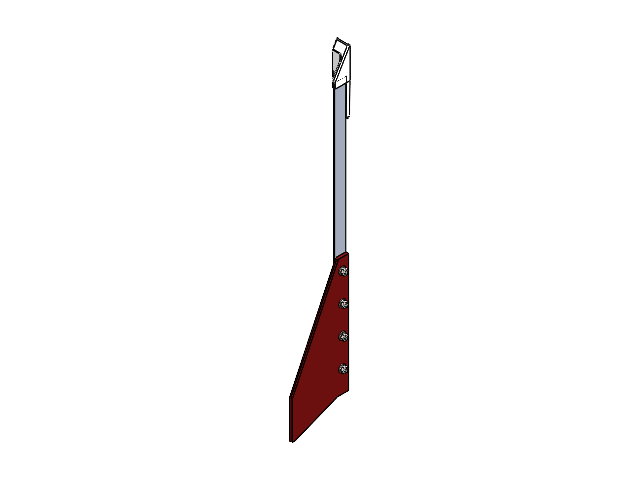
[picture p52: CAD file, 2026-02-24]
CAD/Airframe/Fins/Mojave Sphinx Fin Bracket Assembly.SLDASM
8982K402-OM971-DRILLED Aluminum Angle, 1.00 X 1.00 X .125 X 24 Inches, Drilled, Mojave Sphinx
FIN-STD-250T-4X250C Fin, Standard, Mojave Sphinx
SPCR-400SD-250C-313C Spacer, Fin Bracket to Tank, Mojave Sphinx
AERO-100X100X0125 Aerodynamic Fin Bracket Tip, for 1.00 X 1.00 X .125 Aluminum Angle, Mojave Sphinx
91255A839_Button Head Hex Drive Screw
91306A279_Button Head Hex Drive Screw Zinc Plated x 7
92141A029_18-8 Stainless Steel Washer x 14
95505A601_Medium-Strength Steel Hex Nut x 4
91102A750_Zinc-Plated Steel Split Lock Washer x 5
