Mines-Rocketry-Club/liquid-halfCat/CAD/Propulsion/Thrust Chamber/Mojave Sphinx Thrust Chamber Assembly.SLDASM

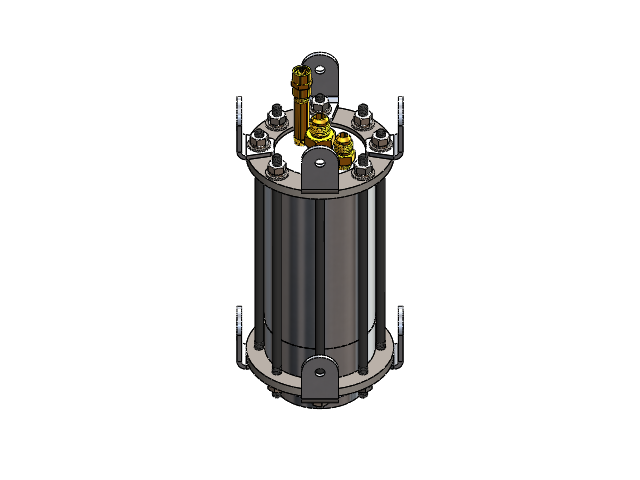
[picture p53: CAD file, 2026-02-24]
CAD/Propulsion/Thrust Chamber/Mojave Sphinx Thrust Chamber Assembly.SLDASM
CMBR-200DI-250B-525L Combustion Chamber, Mojave Sphinx
INJC-2X8NPT-38NPT-250T20-2XO230-GENERIC Injector, Generic Orifice Pattern, Mojave Sphinx
90213A101_Inverted External Retaining Ring
50675K164_37 Degree Flared Fitting for Copper Tubing
9368T14_High-Temperature Dry-Running 841 Bronze Sleeve Bearing
90015A410_Low-Profile Ultra-Wd Truss Head Slotted Screw
50675K435_37 Degree Flared Fitting for Copper Tubing
50785K171_High-Pressure Brass Pipe Nipple
50785K91_High-Pressure Brass Pipe Fitting
9396K79_High-Temperature High-Purity Silicone O-Ring x 2
NZZL-45C20D-200E Nozzle, for Throat Insert, Mojave Sphinx
THRT-45C20D-100T Throat Insert, Spring Retained, Mojave Sphinx
94095K114_High-Temperature Graphite Gasket - Trimmed ID
8284N57_Garter Spring
FLNG-ST-25T-8X250C Flange Plate, Thrust Chamber, Mojave Sphinx x 2
BRKT-90A-125T-2X250C Bracket, Thrust Chamber Mounting, Mojave Sphinx x 8
92141A029_18-8 Stainless Steel Washer x 16
95505A601_Medium-Strength Steel Hex Nut x 16
91102A750_Zinc-Plated Steel Split Lock Washer x 8
