Mines-Rocketry-Club/liquid-halfCat/CAD/Airframe/Avionics/Avionics Sled/Mojave Sphinx Avbavy Sled Assembly.SLDASM

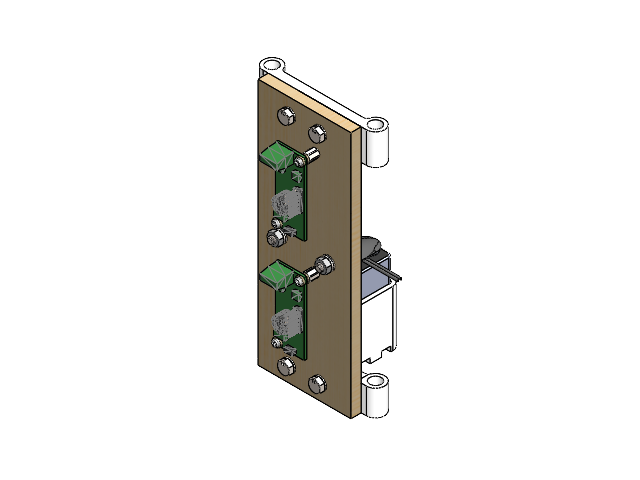
[picture p54: CAD file, 2025-05-20]
CAD/Airframe/Avionics/Avionics Sled/Mojave Sphinx Avbavy Sled Assembly.SLDASM
AVBY-SLD-225X600-6XM4C Avbay Sled, Mojave Sphinx
AVBY-MT-250R-M4C Mount, Avbay Sled, Mojave Sphinx
9V Battery x 2
AVBY-BH-2X9V-250R-M4C Battery Holder, Avbay, Mojave Sphinx
EggTimer Quark x 2
7712K511_Battery Holder x 2
93505A211_Male-Female Threaded Hex Standoff x 4
98689A113_ METRIC GENERAL PURPOSE WASHERS x 12
91280A044_MEDIUM-STRENGTH CLASS 8.8 STEEL HEX HEAD SCREW x 6
90591A141_ZINC-PLATED STEEL HEX NUT x 6
91755A200_Self-Retaining Washer x 8
92148A160_18-8 Stainless Steel Split Lock Washer x 6
93135A013_Off-White Nylon Pan Head Screws x 4
