Mines-Rocketry-Club/liquid-halfCat/CAD/Airframe/Nose Cone/NSCN-ASSM Nose Cone Assembly, Mojave Sphinx.SLDASM

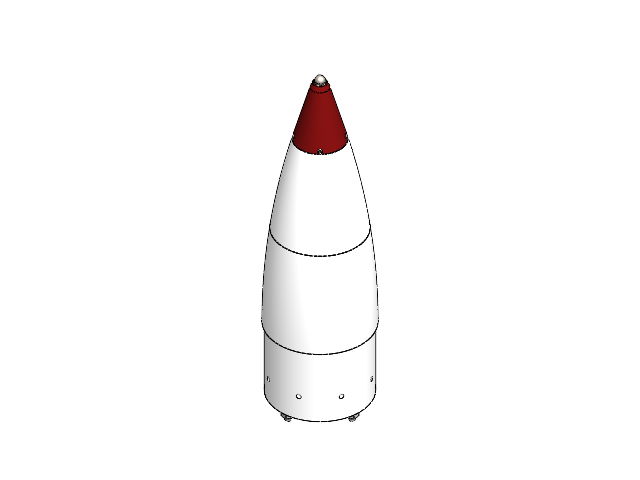
[picture p55: CAD file, 2025-05-20]
CAD/Airframe/Nose Cone/NSCN-ASSM Nose Cone Assembly, Mojave Sphinx.SLDASM
NSCN-SC1-4X250R Nose Cone, Section 1, Mojave Sphinx
NSCN-TIP-4X250R-250HNC Nose Cone Tip, Mojave Sphinx
NSCN-SC2-4X250R Nose Cone, Section 2, Mojave Sphinx
NSCN-SLDR-4X250R-8X832HNC Nose Cone Shoulder, Mojave Sphinx
98831A028 Nylon Threaded Rod Curved Trimmed No Threads MS x 4
93135A013_Off-White Nylon Pan Head Screws x 4
92994A029_316 Stainless Steel Cap Nut
3018T23_Galvanized Steel Eyebolt with Nut and with Shoulder
92141A029_18-8 Stainless Steel Washer x 8
95229A420_Cadmium-Plated Steel MIL. Spec. Washer x 8
91102A750_Zinc-Plated Steel Split Lock Washer x 9
95505A601_Medium-Strength Steel Hex Nut x 8
90480A009_LOW-STRENGTH STEEL HEX NUT x 8
