Mines-Rocketry-Club/liquid-halfCat/(list of files, cad)

Other CAD files:
CAD/Propulsion/Fuel Tank/Ox Bulkhead/BKHD-OX-O238-8NPT-4NPT Tank Bulkhead, Oxidizer, Mojave Sphinx.SLDPRT
CAD/Airframe/Recovery/REC-PRT-DRG-8, Parachute Protector, Drogue, 8 Inch, Mass Volume, Mojave Sphinx.SLDPRT
CAD/Airframe/20545T38-AF-LWR Airframe Tube, Lower, Mojave Sphinx.SLDPRT
CAD/Airframe/20545T38-AF-UPR Airframe Tube, Upper, Mojave Sphinx.SLDPRT
CAD/Airframe/8947T26_Oval-Shaped Threaded Connecting Link.SLDPRT
CAD/Airframe/Avionics/3043T643_U-Bolt.SLDPRT
CAD/Airframe/Avionics/Avionics Sled/7712K511_Battery Holder.SLDPRT
CAD/Airframe/Fins/8982K402-OM971-DRILLED Aluminum Angle, 1.00 X 1.00 X .125 X 24 Inches, Drilled, Mojave Sphinx.SLDPRT
CAD/Airframe/Nose Cone/98831A028 Nylon Threaded Rod Curved Trimmed No Threads MS.SLDPRT
CAD/Airframe/Nose Cone/NSCN-Shoulder.SLDPRT
CAD/Airframe/Nose Cone/NSCN2.SLDPRT
CAD/Fastners/3018T23_Galvanized Steel Eyebolt with Nut and with Shoulder.SLDPRT
CAD/Fastners/90015A410_Low-Profile Ultra-Wd Truss Head Slotted Screw.SLDPRT
CAD/Fastners/90264A435_Zinc-Plated Steel Coupling Nut.SLDPRT
CAD/Fastners/90272A194_ZINC-PLTD STL PAN HEAD PHILLIPS MACHINE SCREW.SLDPRT
CAD/Fastners/90281A102_Black-Oxide Steel Setup Stud.SLDPRT
CAD/Fastners/90357A013_Ultra-Low-Profile Socket Head Screw.SLDPRT
CAD/Fastners/90480A009_LOW-STRENGTH STEEL HEX NUT.SLDPRT
CAD/Fastners/90591A141_ZINC-PLATED STEEL HEX NUT.SLDPRT
CAD/Fastners/91102A750_Zinc-Plated Steel Split Lock Washer.SLDPRT
CAD/Fastners/91255A378_Button Head Hex Drive Screw.SLDPRT
CAD/Fastners/91255A839_Button Head Hex Drive Screw.SLDPRT
CAD/Fastners/91280A044_MEDIUM-STRENGTH CLASS 8.8 STEEL HEX HEAD SCREW.SLDPRT
CAD/Fastners/91290A115_BLACK-OXIDE CLASS 12.9 SOCKET HEAD CAP SCREW.SLDPRT
CAD/Fastners/91306A279_Button Head Hex Drive Screw Zinc Plated.SLDPRT
CAD/Fastners/91755A200_Self-Retaining Washer.SLDPRT
CAD/Fastners/92000A076_18-8 SS METRIC PAN HEAD PHIL MACHINE SCREW.SLDPRT
CAD/Fastners/92141A029_18-8 Stainless Steel Washer.SLDPRT
CAD/Fastners/92148A160_18-8 Stainless Steel Split Lock Washer.SLDPRT
CAD/Fastners/92994A029_316 Stainless Steel Cap Nut.SLDPRT
CAD/Fastners/93135A013_Off-White Nylon Pan Head Screws.SLDPRT
CAD/Fastners/93505A211_Male-Female Threaded Hex Standoff.SLDPRT
CAD/Fastners/95229A420_Cadmium-Plated Steel MIL. Spec. Washer.SLDPRT
CAD/Fastners/95505A601_Medium-Strength Steel Hex Nut.SLDPRT
CAD/Fastners/97654A620_18-8 Stainless Steel Flanged Button Head Screw.SLDPRT
CAD/Fastners/98689A112_ METRIC GENERAL PURPOSE WASHERS.SLDPRT
CAD/Fastners/98689A113_ METRIC GENERAL PURPOSE WASHERS.SLDPRT
CAD/Fittings/4429K421_Low-Pressure Brass Threaded Pipe Fitting.SLDPRT
CAD/Fittings/44665K137_Standard-Wall Aluminum Pipe Nipple.SLDPRT
CAD/Fittings/50675K135_37 Degree Flared Fitting for Copper Tubing.SLDPRT
CAD/Fittings/50675K163_37 Degree Flared Fitting for Copper Tubing.SLDPRT
CAD/Fittings/50675K164_37 Degree Flared Fitting for Copper Tubing.SLDPRT
CAD/Fittings/50675K435_37 Degree Flared Fitting for Copper Tubing.SLDPRT
CAD/Fittings/50785K164_High-Pressure Brass Pipe Fitting.SLDPRT
CAD/Fittings/50785K171_High-Pressure Brass Pipe Nipple.SLDPRT
CAD/Fittings/50785K25_High-Pressure Brass Pipe Fitting.SLDPRT
CAD/Fittings/50785K27_High-Pressure Brass Pipe Fitting.SLDPRT
CAD/Fittings/50785K35_High-Pressure Brass Pipe Fitting.SLDPRT
CAD/Fittings/50785K41_High-Pressure Brass Pipe Fitting.SLDPRT
CAD/Fittings/50785K43_High-Pressure Brass Pipe Fitting.SLDPRT
CAD/Fittings/50785K91_High-Pressure Brass Pipe Fitting.SLDPRT
CAD/Fittings/50785K94_High-Pressure Brass Pipe Fitting.SLDPRT
CAD/Fittings/5485K21_High-Pressure Brass Pipe Fitting.SLDPRT
CAD/Fittings/5485K31_High-Pressure Brass Pipe Fitting.SLDPRT
CAD/Fittings/7768K21_Brass Threaded Check Valve.SLDPRT
CAD/Fittings/9396T31_High-Pressure Push-to-Connect Tube Fitting.SLDPRT
CAD/Propulsion/4468K031_High-Pressure Braided Chemical Hose with Fittings MS Fuel Line.SLDPRT
CAD/Propulsion/4468K865_High-Pressure Braided Chemical Hose with Fittings, Oxidizer Line, Mojave Sphinx.SLDPRT
CAD/Propulsion/Fuel Tank/4468K858_High-Pressure Braided Chemical Hose with Fittings.SLDPRT
CAD/Propulsion/Fuel Tank/93320A215_Polished Unthreaded Spacer.SLDPRT
CAD/Propulsion/Fuel Tank/9452K226_Oil-Resistant Buna-N O-Ring.SLDPRT
CAD/Propulsion/Fuel Tank/94579A550_Steel Offset-Barrel Narrow-Base Weld Nut.SLDPRT
CAD/Propulsion/Fuel Tank/Fuel Bulkhead/91367A952_Chemical-Resistant Fluorosilicone Sealing Washer.SLDPRT
CAD/Propulsion/Fuel Tank/Mojave Sphinx Nut Retaining Ring Subassembly.SLDASM
CAD/Propulsion/Fuel Tank/NTRG-8X3125WN-8X25HN Nut Retaining Ring, Mojave Sphinx.3mf
CAD/Propulsion/Fuel Tank/NTRG-8X3125WN-8X25HN Nut Retaining Ring, Mojave Sphinx.SLDPRT
CAD/Propulsion/Fuel Tank/NTRG-8X3125WN-8X25HN Nut Retaining Ring, Mojave Sphinx.STEP
CAD/Propulsion/Fuel Tank/Ox Bulkhead/9452K15_Oil-Resistant Buna-N O-Ring.SLDPRT
CAD/Propulsion/Fuel Tank/SABV/4112T22_Compact High-Pressure Brass Ball Valve - Handle ONLY.SLDPRT
CAD/Propulsion/Fuel Tank/SABV/4112T22_Compact High-Pressure Brass Ball Valve - Handle Removed.SLDPRT
CAD/Propulsion/Igniter/2155K18_Thick-Wall Aluminum Pipe Nipple.SLDPRT
CAD/Propulsion/Thrust Chamber/Injector/90213A101_Inverted External Retaining Ring.SLDPRT
CAD/Propulsion/Thrust Chamber/Injector/9368T14_High-Temperature Dry-Running 841 Bronze Sleeve Bearing.SLDPRT
CAD/Propulsion/Thrust Chamber/Injector/9396K79_High-Temperature High-Purity Silicone O-Ring.SLDPRT
CAD/Propulsion/Thrust Chamber/Nozzle/94095K114_High-Temperature Graphite Gasket - Trimmed ID.SLDPRT
Machining/Drawings/BKHD-FL-O238-4NPT-2X250C Tank Bulkhead, Fuel, Mojave Sphinx.SLDDRW
Machining/Drawings/BKHD-OX-O238-8NPT-4NPT Tank Bulkhead, Oxidizer, Mojave Sphinx.SLDDRW
Machining/Drawings/CMBR-200DI-250B-525L Combustion Chamber, Mojave Sphinx.SLDDRW
Machining/Drawings/PSTN-2XO238-250T20 Propellant Piston, Mojave Sphinx.SLDDRW
Machining/Drawings/QDC-750X125FLG-281FB-8NPT Quick Disconnect, Female, Mojave Sphinx.SLDDRW
Machining/Drawings/QDC-750x125FLG-270MB-O007-8NPT Quick Disconnect, Male, Mojave Sphinx.SLDDRW
Machining/Drawings/THRT-45C20D-100T Throat Insert, Spring Retained, Mojave Sphinx.SLDDRW
