Mines-Rocketry-Club/liquid-halfCat/Machining/Drawings/THRT-45C20D-100T Throat Insert, Spring Retained, Mojave Sphinx.pdf

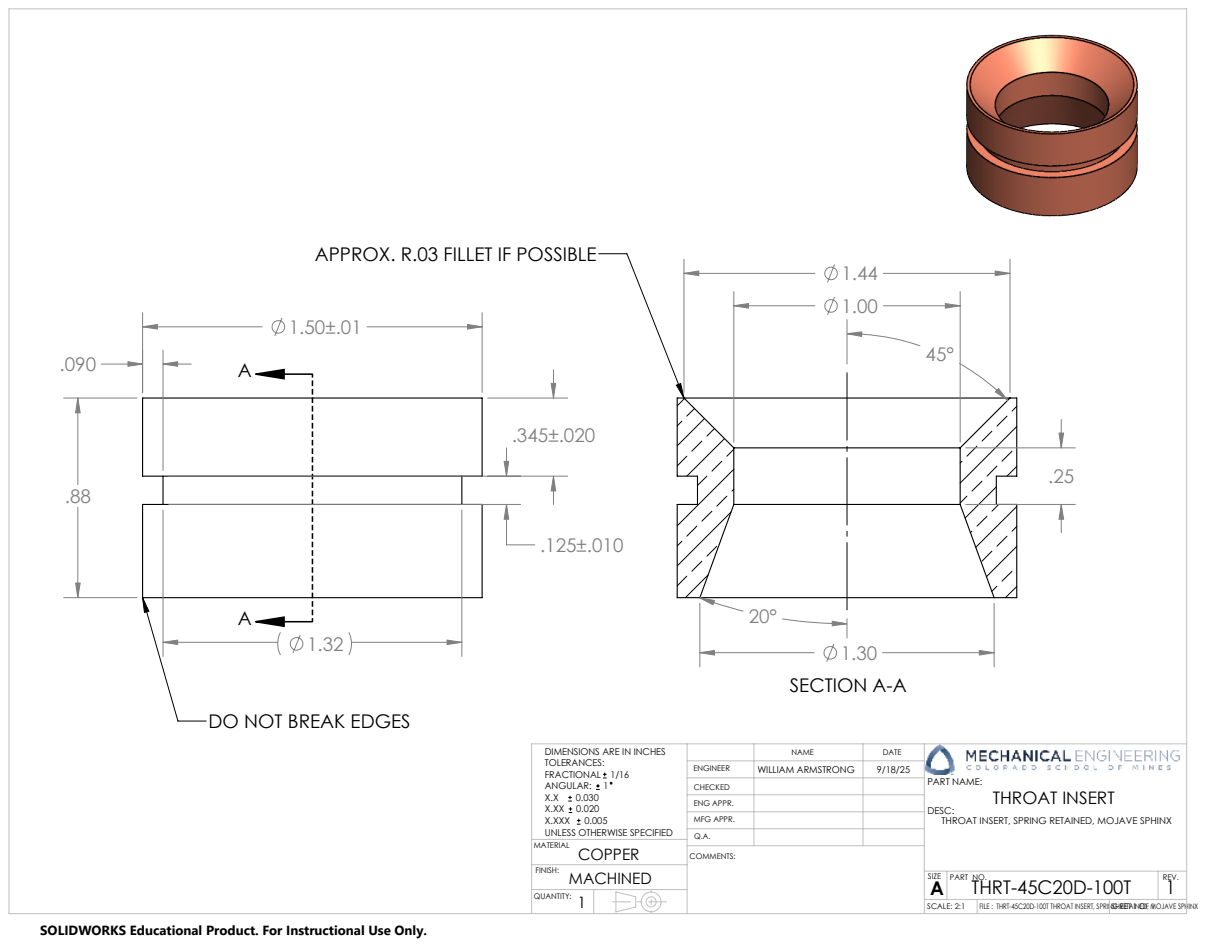
[picture p56: page 1]
SECTION A-A; SCALE: 2:1; A REV. FINISH:; ENG APPR.; MFG APPR.; SHEET 1 OF 1; WILLIAM ARMSTRONG; THRT-45C20D-100T; 1 FILE : THRT-45C20D-100T THROAT INSERT, SPRING RETAINED, MOJAVE SPHINX; THROAT INSERT; QUANTITY: 1; PART NAME:

APPROX. R.03 FILLET IF POSSIBLE

DO NOT BREAK EDGES

DIMENSIONS ARE IN INCHES
TOLERANCES:
FRACTIONAL 1/16
ANGULAR: 1
X.XXX 0.005
UNLESS OTHERWISE SPECIFIED
MATERIAL
COPPER
MACHINED

DESC:
THROAT INSERT, SPRING RETAINED, MOJAVE SPHINX

SIZE PART NO.

SOLIDWORKS Educational Product. For Instructional Use Only.
