Mines-Rocketry-Club/liquid-halfCat/(commit log)

2025-05-20 move files to CAD folder; add document
    [20545T38-AF-LWR Airframe Tube, Lower, Mojave Sphinx.SLDPRT, 20545T38-AF-UPR Airframe Tube, Upper, Mojave Sphinx.SLDPRT, 2155K18_Thick-Wall Aluminum Pipe Nipple.SLDPRT, 25T Servo Horn.SLDPRT, 3018T23_Galvanized Steel Eyebolt with Nut and with Shoulder.SLDPRT, 3043T643_U-Bolt.SLDPRT, 4112T22_Compact High-Pressure Brass Ball Valve - Handle ONLY.SLDPRT, 4112T22_Compact High-Pressure Brass Ball Valve 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]
2025-05-23 finalize injector design w/ CFD
    [91253A029_Black-Oxide Alloy Steel Hex Drive Flat Head Screw.SLDPRT, INJC-2X8NPT-38NPT-250T20-2XO230-GENERIC Injector, Generic Orifice Pattern, Mojave Sphinx.SLDPRT, INJC-Assembly.SLDASM, INJC-SwirlInner.SLDPRT, INJC-SwirlOuter.SLDPRT, ThurstChamberv1.STEP, ThurstChamberv2.STEP, ThurstChamberv3.STEP]
2025-05-27 finish TCA w/ conical nozzle. Add CAM to inner injector
    [INJC-2X8NPT-38NPT-250T20-2XO230-GENERIC Injector, Generic Orifice Pattern, Mojave Sphinx.SLDPRT, INJC-Assembly.SLDASM, INJC-SwirlInner-Cover.SLDPRT, INJC-SwirlInner.SLDPRT, INJC-SwirlOuter.SLDPRT, NZZL-45C20D-200E Nozzle, for Throat Insert, Mojave Sphinx.SLDPRT, THRT-45C20D-100T Throat Insert, Spring Retained, Mojave Sphinx.SLDPRT]
2025-05-29 add outer swirl CAM
    [INJC-SwirlInner.SLDPRT, INJC-SwirlOuter.SLDPRT]
2025-08-29 remove swirl components
    [INJC-2X8NPT-38NPT-250T20-2XO230-GENERIC Injector, Generic Orifice Pattern, Mojave Sphinx.SLDPRT, INJC-Assembly.SLDASM, INJC-SwirlInner-Cover.SLDPRT, INJC-SwirlInner.SLDPRT, INJC-SwirlOuter.SLDPRT]
2025-09-10 add BOM/Order Form
    [PurchaseItems.xlsx]
2025-09-10 add bulkhead machining info
    [BKHD-FL-O238-4NPT-2X250C Tank Bulkhead, Fuel, Mojave Sphinx.SLDDRW, BKHD-FL-O238-4NPT-2X250C Tank Bulkhead, Fuel, Mojave Sphinx.SLDPRT]
2025-09-10 finish bulkhead manufacturing
    [BKHD-FL-O238-4NPT-2X250C Tank Bulkhead, Fuel, Mojave Sphinx.SLDDRW, BKHD-FL-O238-4NPT-2X250C Tank Bulkhead, Fuel, Mojave Sphinx.SLDPRT, BKHD-OX-O238-8NPT-4NPT Tank Bulkhead, Oxidizer, Mojave Sphinx.SLDDRW, BKHD-OX-O238-8NPT-4NPT Tank Bulkhead, Oxidizer, Mojave Sphinx.SLDPRT]
2025-09-12 add Propellant Piston drawings
    [PSTN-2XO238-250T20 Propellant Piston, Mojave Sphinx.SLDDRW, PSTN-2XO238-250T20 Propellant Piston, Mojave Sphinx.SLDPRT, PurchaseItems.xlsx]
2025-09-15 update and add a bunch of drawings
    [BKHD-FL-O238-4NPT-2X250C Tank Bulkhead, Fuel, Mojave Sphinx.SLDDRW, BKHD-FL-O238-4NPT-2X250C Tank Bulkhead, Fuel, Mojave Sphinx.SLDPRT, BKHD-OX-O238-8NPT-4NPT Tank Bulkhead, Oxidizer, Mojave Sphinx.SLDDRW, BKHD-OX-O238-8NPT-4NPT Tank Bulkhead, Oxidizer, Mojave Sphinx.SLDPRT, CMBR-200DI-250B-525L Combustion Chamber, Mojave Sphinx.SLDDRW, CMBR-200DI-250B-525L Combustion Chamber, Mojave Sphinx.SLDPR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]
2025-09-20 add throat drawings
    [THRT-45C20D-100T Throat Insert, Spring Retained, Mojave Sphinx.SLDDRW, THRT-45C20D-100T Throat Insert, Spring Retained, Mojave Sphinx.SLDPRT]
2025-09-23 saved pdf drawings
    [BKHD-FL-O238-4NPT-2X250C Tank Bulkhead, Fuel, Mojave Sphinx.SLDDRW, BKHD-OX-O238-8NPT-4NPT Tank Bulkhead, Oxidizer, Mojave Sphinx.SLDDRW, BKHD-OX-O238-8NPT-4NPT Tank Bulkhead, Oxidizer, Mojave Sphinx.SLDPRT, CMBR-200DI-250B-525L Combustion Chamber, Mojave Sphinx.SLDDRW, CMBR-200DI-250B-525L Combustion Chamber, Mojave Sphinx.SLDPRT, PSTN-2XO238-250T20 Propellant Piston, Mojave Sphinx.SLDDRW, QDC-7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]
2025-09-23 add throat drawings and add PDFs
    [THRT-45C20D-100T Throat Insert, Spring Retained, Mojave Sphinx.SLDDRW, THRT-45C20D-100T Throat Insert, Spring Retained, Mojave Sphinx.SLDPRT]
2025-09-28 made everything 2025
    [20545T38-AF-LWR Airframe Tube, Lower, Mojave Sphinx.SLDPRT, 20545T38-AF-UPR Airframe Tube, Upper, Mojave Sphinx.SLDPRT, 2155K18_Thick-Wall Aluminum Pipe Nipple.SLDPRT, 25T Servo Horn.SLDPRT, 3018T23_Galvanized Steel Eyebolt with Nut and with Shoulder.SLDPRT, 3043T643_U-Bolt.SLDPRT, 4112T22_Compact High-Pressure Brass Ball Valve - Handle ONLY.SLDPRT, 4112T22_Compact High-Pressure Brass Ball Valve 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]
2025-09-30 fix github
    [20545T38-AF-LWR Airframe Tube, Lower, Mojave Sphinx.SLDPRT, 20545T38-AF-UPR Airframe Tube, Upper, Mojave Sphinx.SLDPRT, 2155K18_Thick-Wall Aluminum Pipe Nipple.SLDPRT, 25T Servo Horn.SLDPRT, 3018T23_Galvanized Steel Eyebolt with Nut and with Shoulder.SLDPRT, 3043T643_U-Bolt.SLDPRT, 4112T22_Compact High-Pressure Brass Ball Valve - Handle ONLY.SLDPRT, 4112T22_Compact High-Pressure Brass Ball Valve 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]
2025-10-01 did the nosecone
    [NSCNV2.SLDPRT, NSCNV2.STEP]
2025-10-02 3D Printing Files
    [NTRG-8X3125WN-8X25HN Nut Retaining Ring, Mojave Sphinx.3mf, NTRG-8X3125WN-8X25HN Nut Retaining Ring, Mojave Sphinx.STEP]
2025-10-06 Create THRT-45C20D-100T Throat Insert, Spring Retained, Mojave Sphinx.pdf
2025-10-13 Create Flat pattern - BRKT-90A-125T-2X250C Bracket, Thrust Chamber Mounting, Mojave Sphinx.DXF
    [Flat pattern - BRKT-90A-125T-2X250C Bracket, Thrust Chamber Mounting, Mojave Sphinx.DXF]
2025-10-14 deleted wrong nosecone, added correct shuolder
    [NSCN-Shoulder.SLDPRT, NSCN-Shoulder.STEP, NSCN2.SLDPRT, NSCNV2.3mf, NSCNV2.SLDPRT, NSCNV2.STEP]
2025-10-15 Fixed Shoulder
    [NSCN-Shoulder.SLDPRT, NSCN-Shoulder.STEP]
2025-10-15 add simulations
    [HalfCatSim_v1.3.8_MojaveSphinx - R01.xlsx]
2026-02-24 Made the rail tops fit
    [AERO-100X100X0125 Aerodynamic Fin Bracket Tip, for 1.00 X 1.00 X .125 Aluminum Angle, Mojave Sphinx.SLDPRT, Mojave Sphinx Fin Bracket Assembly.SLDASM, Mojave Sphinx Thrust Chamber Assembly.SLDASM]
